doubleonick/behavior_based_bots/docs/hardware.md

# Hardware notes

What the firmware relies on, and what was learned the hard way. Facts marked
*(tested)* were confirmed on the real robot; the rest come from M5Stack's
documentation.

## Atom Matrix (ESP32-PICO)

| what | pin |
|---|---|
| 5x5 WS2812 LEDs (GRB, index = row * 5 + col, row 0 at the top) | G27 |
| Button (press the screen; LOW when pressed) | G39 |
| Internal I2C to the Motion base and the IMU: SDA / SCL | G25 / G21 |
| Grove Port A (on the Atom itself) | G26, G32 |

- Keep `FastLED.setBrightness` low (the sketches use 20): the matrix is very bright
  and gets warm.
- An old FastLED (the GitHub "FastLED-master" download) fails to compile for current
  ESP32 cores with `RMTMEM` / `gpio_matrix_out` errors. Remove it and install FastLED
  from the Library Manager. *(tested)*

## Atom Motion v1.2

The Motion's own STM32 microcontroller drives the servo and motor ports. The ESP32
only talks to it over the internal I2C bus (address **0x38**). The ESP32 has no
direct connection to the servo signal pins.

| register | meaning |
|---|---|
| 0x00–0x03 | servo S1–S4 **angle**, 1 byte, 0–180. This is what `MotionServo` uses. *(tested)* |
| 0x10, 0x12, 0x14, 0x16 | servo S1–S4 pulse width, 2 bytes, 500–2500 µs. Did not move our servo. *(tested)* |
| 0x20–0x21 | DC motor ports |

- Continuous-rotation servos: 90 = stop. `MotionServo` maps speed −1..1 to an angle,
  with a "mount" setting so "forward" is right for a wheel on either side
  (LEFT: forward is toward 180; RIGHT: forward is toward 0).
- **The servo headers can't be used as inputs.** Their signal pins belong to the STM32,
  and the register map has nothing to read back.
- Grove Port B: G23, G33, **but a unit's first wire lands on G33** (the other way round
  from Ports A and C; see the Key Unit). Grove Port C: G19, G22. *(tested)*
- Two-wheel body: with the servos at the rear of the chassis, Val_Field arced right
  when driving straight with no sensors; moving them to the middle of the chassis
  fixed it, with no change to the code. *(tested)*
- **Charging the battery** (from M5Stack's v1.2 docs): put the Motion's power switch to
  **ON**, then plug USB-C into the Atom (or feed 5 V through a Grove port). The battery
  is a removable 18350 Li-ion, 900 mAh, with DW01-A protection; charging stops at
  4.14 V. The docs don't mention a charge light. v1.2 also has an INA226 power monitor
  (battery voltage and current over I2C), not used yet.
- **On battery, units on the Motion's ports behaved differently from on USB** (Key
  Unit: no response on Ports B and C; on Port A, held HIGH / held LOW instead of
  floating / HIGH). *(seen with Unit_Tester; not yet repeated with a charged battery)*
  Possible causes: a low battery, or the ports getting less (or no) power on battery.
- Power quirk: after the Motion has been off for a long time, its power switch
  sometimes has to be toggled twice before it starts. There is no software fix.
  *(tested)*

## Val_Brooks extras (not yet tried on the robot)

- **Bump switches:** two switches to ground, read with the pin's pull-up (pressed =
  LOW). Default pins G19 (left) and G22 (right), i.e. Port C; change
  `LEFT_BUMPER_PIN` / `RIGHT_BUMPER_PIN` to match the wiring. Keep them off the PaHub's
  port.
- **IMU:** the Atom Matrix v1.1 has a BMI270 on the internal bus (G25 / G21, with the
  Motion). Val_Brooks reads it with the "SparkFun BMI270 Arduino Library", only when
  `INERTIAL_COLLISION` is 1. Which axis is the robot's front depends on how the Atom is
  mounted: set `IMU_FORWARD_AXIS` / `IMU_LEFT_AXIS` and their signs from the Serial
  readings. The v1.0 Atom Matrix has an MPU6886 instead, which this code does not read.
  `firmware/IMU_Test/` reads either chip (the MPU6886 directly, from its data sheet:
  address 0x68, WHO_AM_I 0x75 = 0x19, accelerometer from 0x3B; **not tried on a real
  one**) and shows tilt as a bubble level, for finding out what the IMU can tell about
  Val tipping over an edge, being picked up or falling. Nothing measured yet.

## Units that can't say what they are (not yet tried on the robot)

`firmware/Unit_Tester/` is for finding out what these units really do, pin by pin,
before the Val sketches rely on them: it shows each port pin's reading and whether
anything drives it (read with the weak pull-up, then the weak pull-down: an empty pin
follows them), and can drive a Key's LED once the Key has been pressed.

- **M5 Reflective IR Unit** (`ReflectiveIRSensor`): read as a **level on G32 in Port A**
  (Val_Vehicle, Val_Field: `PORT_A_UNIT IR_UNIT`), or **on/off on G33 in Port B**
  (Val_Brooks; raw 4095 = sees something, LOW on the pin = sees, *assumed, about 80%*).
  Earlier it was read as analog on G33, which was wrong (see below).
  **On the robot (Port B), G33 read binary and inverted** (a strong reflection read as
  "nothing"): so G33 gets the unit's *digital* output, which goes LOW when it sees
  something, and the analog wire lands on G23, which has no ADC. *(tested, reading;
  the digital-vs-analog explanation is the likely cause, not yet confirmed)* Analog
  IR therefore needs Port A (G26 / G32 both have an ADC).
  **Unit_Tester, on the robot:** the unit's two wires land the same way round in every
  port: its digital output on the port's *first* pin, its analog output on the
  *second*. *(tested)*
  - Port A: G26 = digital (on/off), **G32 = analog with a real range: this is where
    analog IR works.** *(tested)*
  - Port B: G23 = digital, clearly on/off. *(tested)* G33 (analog) reads only low or
    high, set by the unit's pot, with a real range only at one tiny spot of the pot.
    *(tested)* Likely cause (not yet confirmed): pull-up resistors on Port B's lines
    (for I2C) dragging the weak analog signal toward 3.3 V. Check: with nothing
    plugged in, does Unit_Tester show Port B's pins as driven?
  - **IR_Test, on the robot:** Port A gives a usable analog reading (G32) on USB and on
    battery; Port B gives on/off only (its analog output lands on G23, no ADC). Where
    to set the pot depends on the use. *(tested)*
  - The pot seems to change how strongly the IR LED shines (it moves the analog
    output too), not only the digital threshold. *(inferred from the above)* 0..4095; calibration decides which way is
  "more". The unit's digital (threshold) output is not used.
- **M5 Light Unit** (U021, labelled "Port B I/O", black; `LightUnitSensor`): read as a
  level on G32, Port A only (Val_Vehicle, Val_Field: `PORT_A_UNIT LIGHT_UNIT`). **Light_Test, on the robot:** wired like the Reflective IR. Port A:
  G26 = on/off, G32 = light level (smooth). Port B: on/off only. *(tested)* More light
  gave a bigger or smaller reading: not recorded (the owner flipped the bars so more
  light shows more).
  So it fits Port A as a level (where the ToF / Color usually go) or Port B as on/off
  (where the IR goes). A cable with its two signal wires swapped would put the level
  on G33, which can read a voltage: untried.
- **M5 Key Unit** (`KeySensor`): a button and one SK6812 LED. Both pins start as
  inputs with pull-ups; the first pin to go LOW is the button and the other becomes
  the LED (added to FastLED then).
  **Port A, with a plain test sketch** (button read with `INPUT_PULLUP`, LED driven with
  FastLED): LED on G26 (the first pin), button on G32 (the second); the button reads
  **LOW when pressed**, HIGH when not; the LED follows the colour sent. *(tested)*
  So `KeySensor`'s pull-up / LOW-when-pressed reading is right after all. Unit_Tester's
  earlier "floating, HIGH when pressed" reading was wrong; its pull-up/pull-down test
  doesn't suit this unit. *(corrected)*
  **All three ports, same sketch, pins set for each port:** *(tested)*

  | port | LED (unit's first wire) | button (second wire) |
  |---|---|---|
  | A | G26 | G32 |
  | B | **G33** | **G23** |
  | C | G19 | G22 |

  **Port B is wired the other way round** from A and C: a unit's first wire lands on
  G33, its second on G23. `KeySensor` already copes (the pin that goes LOW first is
  the button, whichever it is).
  **On battery all three ports work** (blue, red while pressed). **On USB the LED
  shows blue but does not turn red when pressed.** *(tested)* Not yet explained.
  This also explains the Reflective IR on Port B: its digital output (first wire)
  lands on G33, which is why G33 read on/off and inverted, and its analog output lands
  on G23, which has no ADC. So analog IR can only work on Port A. *(inferred from the
  Key result, high confidence)*
  The LED shows the wire / policy colour, dim, and
  bright while pressed; it shares the matrix's `FastLED.setBrightness`.
- Neither can be detected, so a sketch assumes them in Port B / C when no I2C sensor
  answers there. While only assumed (and for a key, until it is first pressed), Val
  keeps looking for an I2C sensor in that port every 5 s and uses one if it appears.

## Grove ports and what they can do

All three ports supply **5 V** on the red wire. ESP32 pins are **3.3 V only**.

| port | pins | read a voltage (ADC)? | notes |
|---|---|---|---|
| A (Atom) | G26, G32 | both | G26 is ADC2: it stops working while Wi-Fi is on. G32 (ADC1) always works. |
| B (Motion) | G23, G33 | G33 only | |
| C (Motion) | G19, G22 | neither | on/off signals only |

The sketches use a second I2C bus (`Wire1`) for the plug-in sensors and point it at a
port's pins just before each read (`I2CBus::use`). That lets one sketch serve three
ports, and lets two sensors with the same address work at once, one per port. It also
tries both wire orders, so SDA/SCL orientation never matters.

### What each unit can do in each port

**T** = tested on the robot. **E** = expected from the wiring or the firmware, not
yet tried. "Level" = a smooth reading (0..4095, or millimetres); "on/off" = only two
values.

| unit | Port A (G26 / G32) | Port B (G33 / G23) | Port C (G19 / G22) | PaHub channel | Val recognises it? | in Val's sketches |
|---|---|---|---|---|---|---|
| Color Unit (TCS3472) | level, E | level, E | level, E | level, E | yes (chip ID) | yes, any port |
| 90° ToF (VL53L0X) | level (mm), E | level (mm), E | level (mm), E | level (mm), **T** (Field, channels 0 and 1) | yes (chip ID) | yes, any port |
| Reflective IR | **level on G32, T**; on/off on G26, T | **on/off only on G33, T** | on/off only, E | no (not I2C) | no | Port A, a level (Brooks: Port B, on/off) |
| Light Unit (U021) | **level on G32, T**; on/off on G26, T | **on/off only on G33, T** | on/off only, E | no (not I2C) | no | Port A, a level |
| Key | **button G32, LED G26, T** | **button G23, LED G33, T** | **button G22, LED G19, T** | no (not I2C) | no | Port C (Brooks: A and C) |

Notes:
- **Port B is wired the other way round:** a unit's first wire lands on G33, its second
  on G23. G23 can't read a voltage, so the IR's and Light Unit's level is lost there.
  *(tested with the Key)*
- Key: works on all three ports on battery; on USB the LED showed but presses were
  not seen. *(tested, not explained)*
- IR and Light Unit on Port A: tested on USB and on battery (IR); Light Unit power
  source not recorded.
- The I2C units are found in any port by the firmware (both wire orders are tried);
  which ports each has actually been plugged into on the robot is not recorded.

### Which units fit together (one Atom + Motion)

Three ports, so three units at most, and only **one** level from an analog unit
(Port A). A PaHub in a port takes up to 6 I2C units (ToF, Color), but not analog
units or the Key: those still need a port of their own.

## Sensors the firmware recognises

Both answer at I2C address **0x29**, so the firmware asks each chip for its ID:

| sensor | chip | ID check | raw reading |
|---|---|---|---|
| M5 Color Unit | TCS3472 | register 0x92 (0x80 \| 0x12) reads 0x44, 0x4D or 0x10 | clear channel, 0–65535 (gain 4x, ~154 ms) |
| M5 ToF Unit | VL53L0X | registers 0xC0 / 0xC1 read 0xEE / 0xAA | distance in mm, capped at 2000 |

DFRobot's SEN0245 is the same VL53L0X chip, so it is recognised too.

**Pointing the Color Unit for light vehicles:** for V1 under a light shining down on
the floor (a flashlight on a stand), the Color Unit worked best **pointing up**, at
the light, not forward. *(tested, owner's filming, 2026-11)* Facing forward it sees
mostly the floor and the far wall, so the reading changes little as Val drives
through the pool of light.

Every sensor turns its raw reading into a 0..1 stimulus, a straight line between
two calibration points taken during setup: "low" (no stimulus) and "high" (full
stimulus). For distance, "high" is the *smaller* number (near).

## Considered and not used

- **DFRobot Gravity 3-pin sensors** (DFR0029 button, SEN0138 crash, DFR0034 sound).
  They need a voltage divider on Grove's 5 V, can't be told apart by the robot, and
  sound needs an ADC pin. Too fiddly for the audience. A tester sketch was written
  and then removed.
## M5 Unit PaHub (Val_Field only, for now)

A PCA9548A at address **0x70** with six channels. It connects one channel at a time
to its input (write one byte: bit n = channel n; 0 = all off), so sensors on
different channels can share an address: two distance sensors, or two light
sensors, on one port.

- Val_Field looks for a hub on each port (both wire orders) before looking for
  sensors. A port with a hub holds only the hub; its six channels are searched
  instead and named "Hub 0" to "Hub 5" by channel number.
- Every read switches the hub to that sensor's channel first (`I2CBus::use`).
- The setup screens have room for 3 sensors, so only the first 3 found are used.
- Channel numbering 0-5 matches the code and the robot: Hub 0 and Hub 1 are the
  channels the unit calls 0 and 1. *(tested)*
- Two ToF Units on one hub (right on channel 0, left on channel 1): found, set up,
  push/pull and the mounting angles all behave as expected in Val_Field, spikes
  included. *(tested)* Two light sensors on a hub: not tried on the robot yet.
