doubleonick/behavior_based_bots/cad/mg996_clamp.png

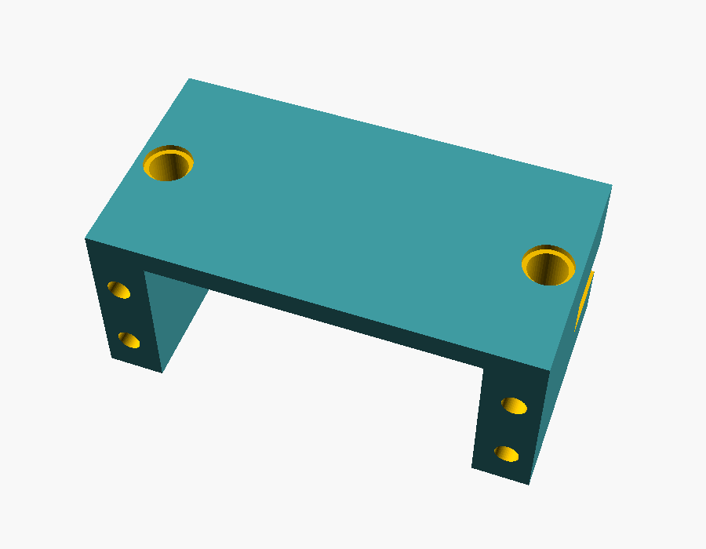
cad/mg996_clamp.png
