doubleonick/behavior_based_bots/cad/mg996_frame.png

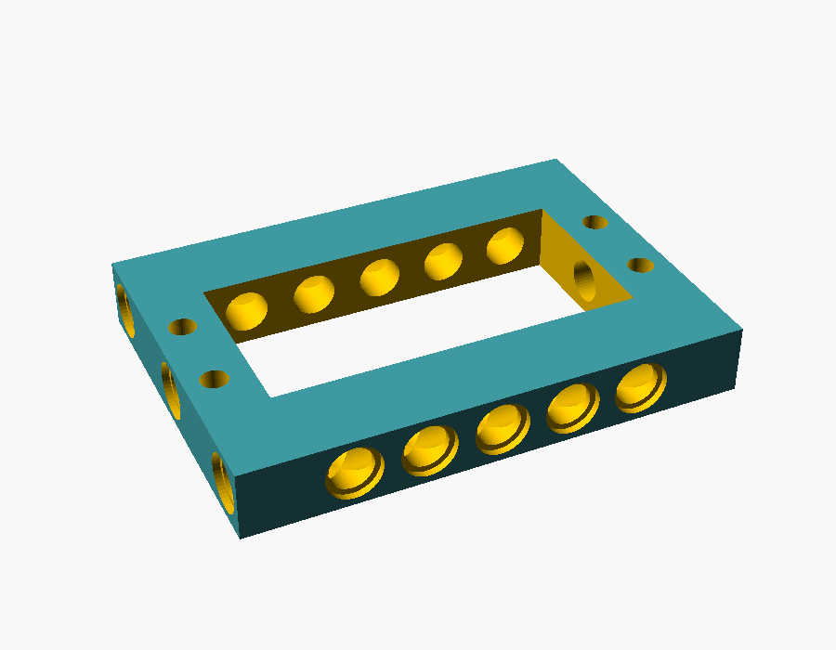
cad/mg996_frame.png
