doubleonick/behavior_based_bots/cad/mg996_horn_adapter.png

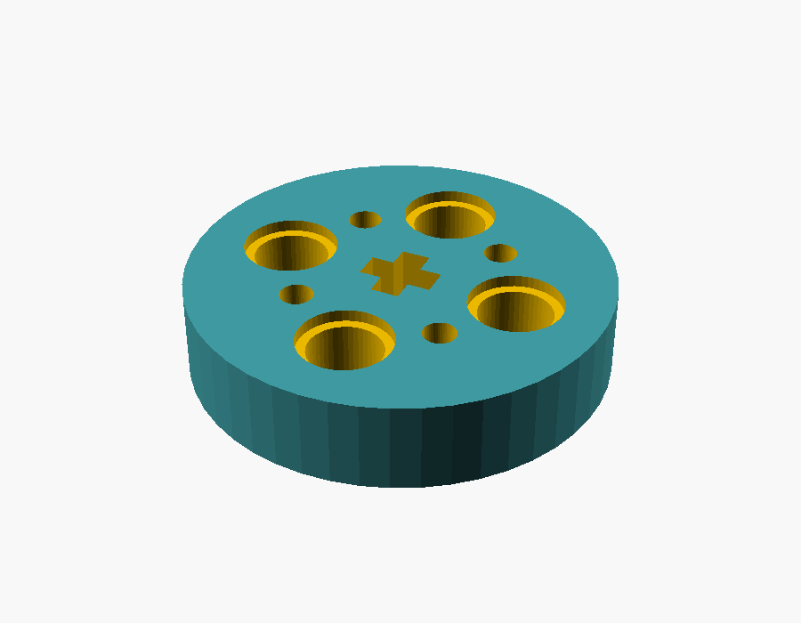
cad/mg996_horn_adapter.png
