doubleonick/behavior_based_bots/cad/mg996_preview.png

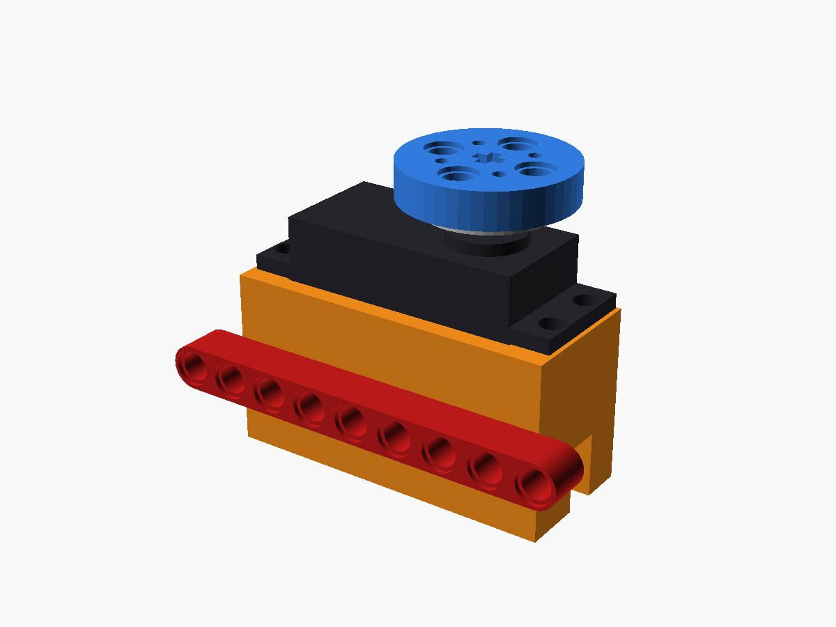
cad/mg996_preview.png
