doubleonick/behavior_based_bots/cad/mg996_preview_back.png

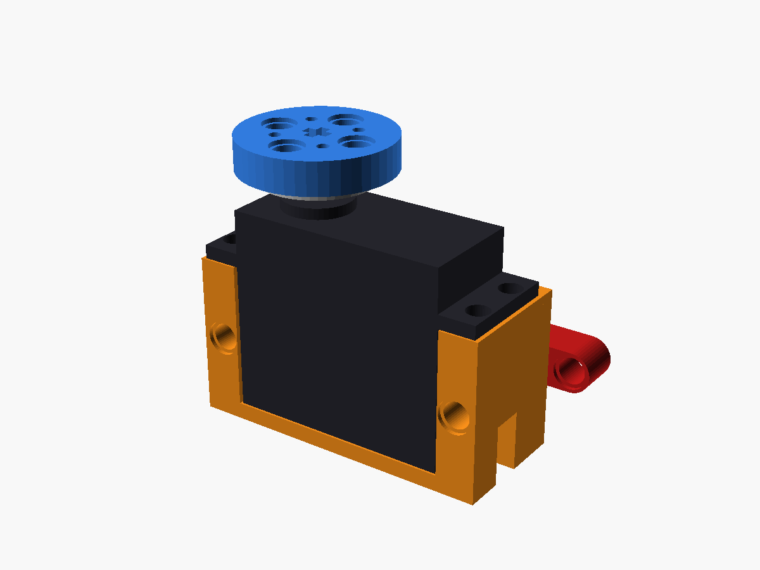
cad/mg996_preview_back.png
