doubleonick/behavior_based_bots/cad/render/val_v1_above_rear.png

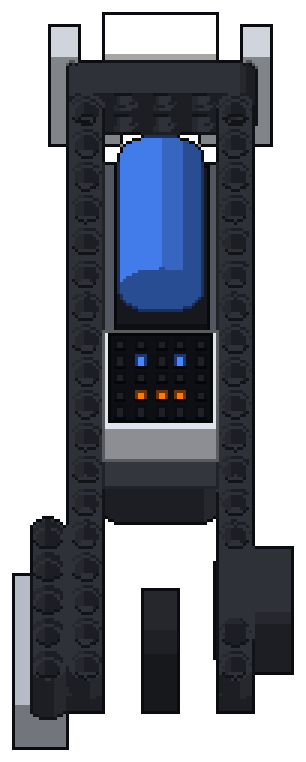
cad/render/val_v1_above_rear.png
