doubleonick/behavior_based_bots/cad/render/val_v1_rear34.png

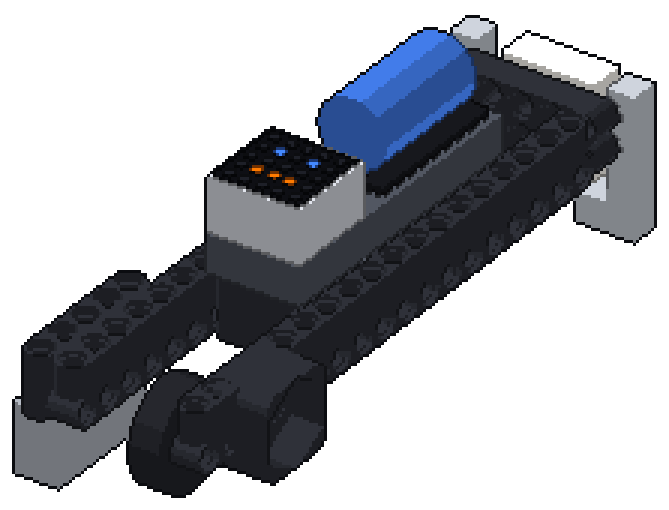
cad/render/val_v1_rear34.png
