doubleonick/behavior_based_bots/cad/render/val_v1_top.png

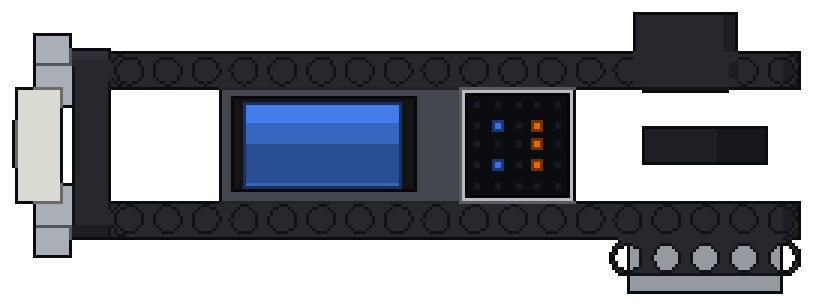
cad/render/val_v1_top.png
