doubleonick/behavior_based_bots/cad/servo_wheel_horn.png

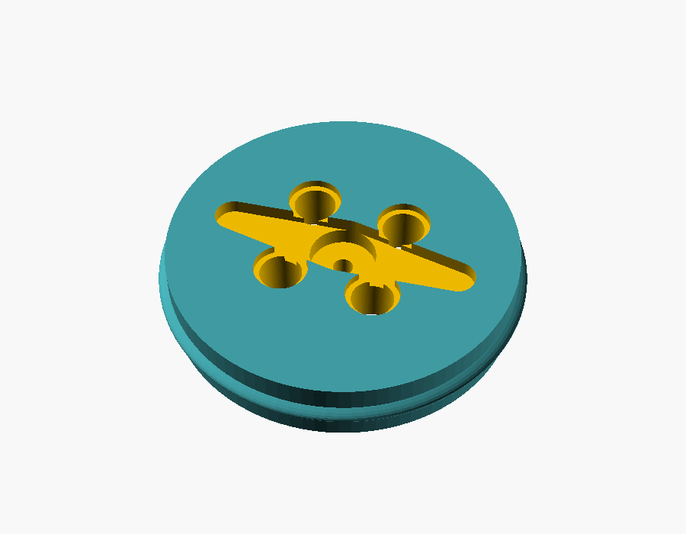
cad/servo_wheel_horn.png
