doubleonick/behavior_based_bots/cad/servo_wheel_m5.png

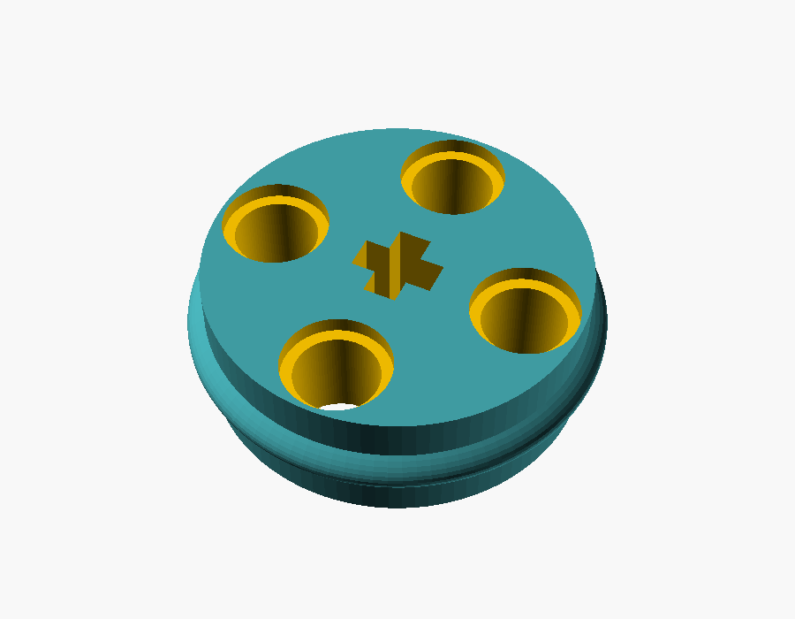
cad/servo_wheel_m5.png
