doubleonick/behavior_based_bots/cad/render/val_v1_chassis.scad

use <../vechicles_v2.scad>
val_brooks(0);
