doubleonick/behavior_based_bots/firmware/Val_Brooks/Val_Brooks.ino

/*
  Val_Brooks - behaviours in a fixed hierarchy (subsumption, after Rodney Brooks).

  Several simple behaviours run all the time. Each one keeps asking "do I want the
  wheels right now?". The highest one in the hierarchy that says yes drives the
  wheels; the ones below it are held back (suppressed) until it lets go.

  Hardware: M5 Atom Matrix on an Atom Motion base
            two continuous-rotation servos: S1 = LEFT wheel, S2 = RIGHT wheel
            an M5 PaHub in Port B (any port the keys don't use), with sensors on its channels:
              even channels (0, 2, 4) = the RIGHT side, odd channels (1, 3, 5) = the LEFT side
              M5 ToF Unit (VL53L0X)    distance
              M5 Color Unit (TCS3472)  light
              (for example: right ToF on 0, left ToF on 1, right light on 2, left light on 3)
              With only ONE Color Unit (on either side), the light behaviours compare
              its reading now with 0.2 s ago: getting brighter counts as "brighter on
              its side", getting darker as "brighter on the other side".
            for button collisions: two M5 Key Units, the LEFT one in Port A and the
              RIGHT one in Port C (or one key, or bump switches: see BUMPERS below)
            optionally an M5 Reflective IR Unit in Port B (analog on G33): "something
              just ahead" for the object behaviours
            for inertial collisions: the Atom Matrix's own IMU (BMI270, see INERTIAL_COLLISION)

  Pick the hierarchy to test in the TEST HIERARCHY section below, by leaving exactly
  one line uncommented, and the behaviour at its bottom (BOTTOM: wander or cruise). This sketch is a test bench: it has no setup screens, and its
  settings (thresholds, speeds, pins) are near the top of this file.

  The matrix:
  - Val says "Hello, my name is, Val", then the behaviours start.
  - While running, one row per behaviour (top = top of the hierarchy):
      column 0: red = push / avoid, green = pull / approach (wander: green going
      forwards, red going backwards); column 1: a gap; columns 2-4: the behaviour's
      colour: collision white, distance purple, light yellow, wander / cruise blue.
    Rows not in control stay steady. The row in control sends spikes left to right,
    as often as the wheels' average speed says.
  - Short press on the matrix: pause (wheels stop, Neutral face) / carry on.
  - Long press on the matrix: the behaviour display off (the matrix goes dark) / on.
    With it off, the robot gives nothing away: for watching what it does and
    working out its hierarchy from behaviour alone. SHOW_LAYERS_AT_START sets how
    it begins.

  Keep all these files together in a folder named Val_Brooks. The shared ones
  (Face, Static, Canvas, Palette, Icons, MotionServo, Port, I2CBus, Sensor, ColorSensor,
  DistanceSensor, ReflectiveIRSensor, KeySensor, Button)
  are copies of firmware/shared/ - edit them there and run sync_shared.py.

  Libraries needed: FastLED, VL53L0X by Pololu, and only for INERTIAL_COLLISION 1:
  "SparkFun BMI270 Arduino Library".
  Readings print on Serial at 115200 baud.
*/

#include <Wire.h>
#include <FastLED.h>
#include "Face.h"
#include "Button.h"
#include "MotionServo.h"
#include "ColorSensor.h"
#include "DistanceSensor.h"
#include "ReflectiveIRSensor.h"
#include "KeySensor.h"
#include "I2CBus.h"
#include "Layers.h"

// =====================================================================
//  TEST HIERARCHY: uncomment exactly ONE line (top of the hierarchy first)
// =====================================================================
// #define TEST_ESCAPE_LEFT      // 1. escape left collision  -> bottom
// #define TEST_ESCAPE_RIGHT     // 2. escape right collision -> bottom
// #define TEST_AVOID_OBJECT     // 3. avoid object           -> bottom
// #define TEST_APPROACH_OBJECT  // 4. approach object        -> bottom
// #define TEST_AVOID_LIGHT      // 5. avoid light            -> bottom
// #define TEST_APPROACH_LIGHT   // 6. approach light         -> bottom
#define TEST_FULL                // escape front collision -> avoid object -> approach light -> bottom

// The bottom of the hierarchy has no condition: it always wants the wheels, so nothing
// can go below it. Uncomment exactly ONE:
#ifndef BOTTOM
#define BOTTOM WANDER            // roll a die every 0.2 s for one of six moves
// #define BOTTOM CRUISE_STRAIGHT   // a "forced roll": always straight ahead at half speed
#endif

// ---------- Collision detection: which kind? ----------
// 0 = bump switches (is_button_collision), 1 = the IMU (is_inertial_collision)
#define INERTIAL_COLLISION 0

// ---------- Settings ----------
const uint8_t LED_BRIGHTNESS = 20;    // keep low: the matrix is very bright and gets warm
const bool SHOW_LAYERS_AT_START = true;   // false: start with the behaviour display off (dark)

// Bumpers: 1 = one M5 Key Unit in Port C, a front bumper (it counts as left AND right)
//           2 = two bump switches on Port C: left on G19, right on G22, pressed = LOW
//              (they use the pin's pull-up)
//           3 = two M5 Key Units: the LEFT one in Port A, the RIGHT one in Port C
//              (to swap sides, swap leftKey and rightKey below)
// Key LEDs show red ("push away"), like the setup screens.
#ifndef BUMPERS
#define BUMPERS 3
#endif
const int LEFT_BUMPER_PIN  = 19;
const int RIGHT_BUMPER_PIN = 22;

// Reflective IR in Port B: 1 = use one if no PaHub is there, 0 = don't
#ifndef ASSUME_IR_ON_PORT_B
#define ASSUME_IR_ON_PORT_B 1
#endif
// A raw reading (0..4095) past this means "something just ahead". Which way "past" is
// depends on the unit: watch the "ir" number on Serial with and without something there.
const long IR_NEAR_RAW = 2000;
const bool IR_NEAR_IS_HIGH = true;    // true: something near gives a BIGGER reading

// Distance: an object nearer than this (mm) on either side is "there"
const long DISTANCE_THRESHOLD_MM = 300;
// Light: (left - right) / (left + right) must be at least this, either way, to count
const float LIGHT_GRADIENT_THRESHOLD = 0.25f;
const long  LIGHT_MINIMUM = 50;       // left + right below this: too dark to tell
// One light sensor only (no pair): it compares now with PRIMITIVE_MS ago instead.
// A change of at least this fraction (0.15 = 15% brighter or darker) counts.
const float LIGHT_CHANGE_THRESHOLD = 0.15f;

// IMU (only with INERTIAL_COLLISION 1). A bump is a sudden change in acceleration.
const float IMPACT_G = 0.6f;          // how big a sudden change counts as a bump (in g)
// Which IMU axis points to the robot's front and which to its left, and their signs.
// Depends on how the Atom sits on the robot: check with the Serial readings.
const int   IMU_FORWARD_AXIS = 0;     // 0 = x, 1 = y, 2 = z
const float IMU_FORWARD_SIGN = 1.0f;
const int   IMU_LEFT_AXIS    = 1;
const float IMU_LEFT_SIGN    = 1.0f;

// Speeds (-1..1, positive = forwards)
const float STRAIGHT_SPEED = 0.5f;
const float ARC_FAST = 0.55f;         // the outside wheel of an arc
const float ARC_SLOW = 0.25f;         // the inside wheel of an arc
const float ROTATE_SPEED = 0.4f;      // turning on the spot: one wheel forwards, one backwards
const float CRUISE_SPEED = 0.5f;      // cruise straight

// Timing
const unsigned long PRIMITIVE_MS = 200;     // wander rolls the die this often; approach and
                                            // avoid turn for this long, then look again
const unsigned long ESCAPE_MS = 1000;       // escape: back away (one side hit) or turn on the
                                            // spot (both sides hit) for this long
const unsigned long BOTH_WINDOW_MS = 100;   // the other key pressed within this long counts as both

#if INERTIAL_COLLISION
#include "SparkFun_BMI270_Arduino_Library.h"
BMI270 imu;
#endif

// ---------- Hardware ----------
CRGB leds[25];
Face face(leds);
Layers layers(leds);
Button button(39);                    // the Matrix screen is the button
MotionServo leftWheel(1);             // S1
MotionServo rightWheel(2);            // S2

// ---------- Sensors on the PaHub ----------
const int PORT_COUNT = 3;
const Port PORTS[PORT_COUNT] = {PORT_A, PORT_B, PORT_C};
const int CHANNELS = I2CBus::HUB_CHANNELS;
Port hubPlace[CHANNELS] = {
  {"Hub 0", -1, -1, 0}, {"Hub 1", -1, -1, 1}, {"Hub 2", -1, -1, 2},
  {"Hub 3", -1, -1, 3}, {"Hub 4", -1, -1, 4}, {"Hub 5", -1, -1, 5}
};
ColorSensor colorSensor[CHANNELS] = {
  ColorSensor(hubPlace[0]), ColorSensor(hubPlace[1]), ColorSensor(hubPlace[2]),
  ColorSensor(hubPlace[3]), ColorSensor(hubPlace[4]), ColorSensor(hubPlace[5])
};
DistanceSensor distanceSensor[CHANNELS] = {
  DistanceSensor(hubPlace[0]), DistanceSensor(hubPlace[1]), DistanceSensor(hubPlace[2]),
  DistanceSensor(hubPlace[3]), DistanceSensor(hubPlace[4]), DistanceSensor(hubPlace[5])
};
int hubPort = -1;                     // which port the PaHub is in (-1 = none found)

ReflectiveIRSensor reflectiveIR(PORT_B);
KeySensor keyA(PORT_A);
KeySensor keyC(PORT_C);
KeySensor* leftKey = &keyA;           // BUMPERS 3: which key is on which side
KeySensor* rightKey = &keyC;

// The sensors each behaviour uses (nullptr = not plugged in)
Sensor* leftDistance  = nullptr;
Sensor* rightDistance = nullptr;
Sensor* leftLight     = nullptr;
Sensor* rightLight    = nullptr;

// ---------- The behaviours ----------
enum Behaviour : uint8_t {
  ESCAPE_LEFT_COLLISION, ESCAPE_RIGHT_COLLISION, ESCAPE_FRONT_COLLISION,
  AVOID_OBJECT, APPROACH_OBJECT, AVOID_LIGHT, APPROACH_LIGHT, WANDER, CRUISE_STRAIGHT,
  BEHAVIOUR_COUNT                     // (not a behaviour: how many there are)
};

#if defined(TEST_ESCAPE_LEFT)
const Behaviour HIERARCHY[] = {ESCAPE_LEFT_COLLISION, BOTTOM};
#elif defined(TEST_ESCAPE_RIGHT)
const Behaviour HIERARCHY[] = {ESCAPE_RIGHT_COLLISION, BOTTOM};
#elif defined(TEST_AVOID_OBJECT)
const Behaviour HIERARCHY[] = {AVOID_OBJECT, BOTTOM};
#elif defined(TEST_APPROACH_OBJECT)
const Behaviour HIERARCHY[] = {APPROACH_OBJECT, BOTTOM};
#elif defined(TEST_AVOID_LIGHT)
const Behaviour HIERARCHY[] = {AVOID_LIGHT, BOTTOM};
#elif defined(TEST_APPROACH_LIGHT)
const Behaviour HIERARCHY[] = {APPROACH_LIGHT, BOTTOM};
#elif defined(TEST_FULL)
const Behaviour HIERARCHY[] = {ESCAPE_FRONT_COLLISION, AVOID_OBJECT, APPROACH_LIGHT, BOTTOM};
#else
#error "Uncomment one TEST_ line in the TEST HIERARCHY section"
#endif
const int LEVELS = sizeof(HIERARCHY) / sizeof(HIERARCHY[0]);

// ---------- State ----------
float wheelLeft = 0;                  // what the behaviour in control asked for
float wheelRight = 0;
int inControl = -1;                   // index into HIERARCHY
bool paused = false;
bool showLayers = SHOW_LAYERS_AT_START;   // long press turns the behaviour display on / off
bool matrixDark = false;              // the display is off and the matrix has been cleared
bool greetingDone = false;
unsigned long lastPrintMs = 0;

// An escape is a fixed move: once it starts, it runs to the end
enum EscapeMove : uint8_t { BACK_LEFT, BACK_RIGHT, SPIN_LEFT, SPIN_RIGHT };
struct Escape {
  bool running = false;
  unsigned long startMs = 0;
  EscapeMove move = BACK_LEFT;
};
Escape escape;

// Approach and avoid: a turn on the spot lasts PRIMITIVE_MS, then the behaviour looks again
struct Turn {
  bool running = false;
  unsigned long startMs = 0;
  bool right = true;
};
Turn turns[BEHAVIOUR_COUNT];

// One light sensor: its reading now and PRIMITIVE_MS ago
long lightNow = 0;
long lightBefore = 0;
unsigned long lastLightSampleMs = 0;
bool lightSampled = false;            // false until there are two samples to compare

// Wander: the current roll of the die and when it was rolled
int wanderRoll = 0;                   // 0..5
unsigned long lastRollMs = 0;
bool wanderStarted = false;

// =====================================================================
//  Finding the hub and the sensors on it
// =====================================================================
void findHub() {
  for (int p = 0; p < PORT_COUNT; p++) {
    const int orders[2][2] = {{PORTS[p].pin1, PORTS[p].pin2}, {PORTS[p].pin2, PORTS[p].pin1}};
    for (int n = 0; n < 2; n++) {
      I2CBus::use(orders[n][0], orders[n][1]);
      if (!I2CBus::hubAnswers()) {
        continue;
      }
      I2CBus::hubAllOff();
      hubPort = p;
      for (int ch = 0; ch < CHANNELS; ch++) {
        hubPlace[ch].pin1 = PORTS[p].pin1;
        hubPlace[ch].pin2 = PORTS[p].pin2;
        colorSensor[ch].setPort(hubPlace[ch]);
        distanceSensor[ch].setPort(hubPlace[ch]);
      }
      Serial.printf("PaHub found on %s\n", PORTS[p].name);
      return;
    }
  }
  Serial.println("No PaHub found: distance and light behaviours will never act");
}

// Even channels are the right side, odd channels the left
void findSensors() {
  if (hubPort < 0) {
    return;
  }
  for (int ch = 0; ch < CHANNELS; ch++) {
    bool left = (ch % 2 == 1);
    if (distanceSensor[ch].begin()) {
      if (left && leftDistance == nullptr) {
        leftDistance = &distanceSensor[ch];
      } else if (!left && rightDistance == nullptr) {
        rightDistance = &distanceSensor[ch];
      }
    } else if (colorSensor[ch].begin()) {
      if (left && leftLight == nullptr) {
        leftLight = &colorSensor[ch];
      } else if (!left && rightLight == nullptr) {
        rightLight = &colorSensor[ch];
      }
    }
  }
}

bool present(Sensor* s) {
  return s != nullptr && s->isConnected();
}

void updateSensors() {
  Sensor* all[7] = {leftDistance, rightDistance, leftLight, rightLight, &reflectiveIR, &keyA, &keyC};
  for (int k = 0; k < 7; k++) {
    if (all[k] != nullptr) {
      all[k]->update();
    }
  }
}

// =====================================================================
//  Detection: what is out there?
// =====================================================================
bool is_left_bumper_pressed() {
#if BUMPERS == 1
  return keyC.pressed();              // one key at the front: it is both sides
#elif BUMPERS == 2
  return digitalRead(LEFT_BUMPER_PIN) == LOW;
#else
  return leftKey->pressed();
#endif
}

bool is_right_bumper_pressed() {
#if BUMPERS == 1
  return keyC.pressed();
#elif BUMPERS == 2
  return digitalRead(RIGHT_BUMPER_PIN) == LOW;
#else
  return rightKey->pressed();
#endif
}

// A bump switch was pressed (either side)
bool is_button_collision() {
  return is_left_bumper_pressed() || is_right_bumper_pressed();
}

// ---- The IMU: a bump is a sudden change in acceleration ----
float impactForward = 0;              // how big the latest sudden change is, toward the front
float impactLeft = 0;                 // ... and toward the left

#if INERTIAL_COLLISION
float slowAccel[3] = {0, 0, 0};       // acceleration, followed slowly (gravity and steady driving)
bool imuReady = false;
unsigned long lastImuMs = 0;

void beginImu() {
  imuReady = (imu.beginI2C(BMI2_I2C_PRIM_ADDR, Wire) == BMI2_OK);
  Serial.printf("IMU (BMI270) %s\n", imuReady ? "found" : "NOT found");
}

// Read the IMU every 10 ms; a sudden change = this reading minus the slow average
void updateImu() {
  if (!imuReady || millis() - lastImuMs < 10) {
    return;
  }
  lastImuMs = millis();
  if (imu.getSensorData() != BMI2_OK) {
    return;
  }
  float a[3] = {imu.data.accelX, imu.data.accelY, imu.data.accelZ};
  float sudden[3];
  for (int k = 0; k < 3; k++) {
    sudden[k] = a[k] - slowAccel[k];
    slowAccel[k] += 0.05f * (a[k] - slowAccel[k]);
  }
  impactForward = IMU_FORWARD_SIGN * sudden[IMU_FORWARD_AXIS];
  impactLeft = IMU_LEFT_SIGN * sudden[IMU_LEFT_AXIS];
}
#else
void beginImu() {
}

void updateImu() {
}
#endif

// A sudden jolt bigger than IMPACT_G, from any side
bool is_inertial_collision() {
#if INERTIAL_COLLISION
  return sqrtf(impactForward * impactForward + impactLeft * impactLeft) >= IMPACT_G;
#else
  return false;                       // not compiled in: set INERTIAL_COLLISION to 1
#endif
}

// Something hit the left side: the left bumper, or a jolt that pushes the robot right
bool is_left_collision() {
#if INERTIAL_COLLISION
  return is_inertial_collision() && impactLeft < 0;
#else
  return is_left_bumper_pressed();
#endif
}

bool is_right_collision() {
#if INERTIAL_COLLISION
  return is_inertial_collision() && impactLeft > 0;
#else
  return is_right_bumper_pressed();
#endif
}

// Something hit the front: left and right together (bump switches), or any jolt (IMU)
bool is_front_collision() {
#if INERTIAL_COLLISION
  return is_inertial_collision();
#else
  return is_button_collision();
#endif
}

// Does the reflective IR see something just ahead?
bool is_ir_object_ahead() {
  if (!present(&reflectiveIR)) {
    return false;
  }
  if (IR_NEAR_IS_HIGH) {
    return reflectiveIR.raw() >= IR_NEAR_RAW;
  }
  return reflectiveIR.raw() <= IR_NEAR_RAW;
}

// Is an object nearer than DISTANCE_THRESHOLD_MM on either side (or just ahead, by IR)?
bool is_distance_threshold() {
  bool leftNear = present(leftDistance) && leftDistance->raw() < DISTANCE_THRESHOLD_MM;
  bool rightNear = present(rightDistance) && rightDistance->raw() < DISTANCE_THRESHOLD_MM;
  return leftNear || rightNear || is_ir_object_ahead();
}

// ---- Light: a pair compares left with right; one sensor compares now with before ----
bool light_pair() {
  return present(leftLight) && present(rightLight);
}

// The only light sensor, if there is exactly one (nullptr otherwise)
Sensor* single_light() {
  if (light_pair()) {
    return nullptr;
  }
  if (present(leftLight)) {
    return leftLight;
  }
  if (present(rightLight)) {
    return rightLight;
  }
  return nullptr;
}

// One sensor: take a sample every PRIMITIVE_MS
void sample_light() {
  Sensor* s = single_light();
  if (s == nullptr) {
    lightSampled = false;
    return;
  }
  if (lastLightSampleMs != 0 && millis() - lastLightSampleMs < PRIMITIVE_MS) {
    return;
  }
  lightSampled = (lastLightSampleMs != 0);
  lastLightSampleMs = millis();
  lightBefore = lightNow;
  lightNow = s->raw();
}

// One sensor: how much brighter it got since the last sample (0.5 = 50% brighter, - = darker)
float light_change() {
  if (single_light() == nullptr || !lightSampled) {
    return 0;
  }
  long before = max(lightBefore, LIGHT_MINIMUM);
  return (float)(lightNow - lightBefore) / before;
}

// How much brighter the left is than the right: -1 (all right) .. +1 (all left).
// One sensor: getting brighter counts as "brighter on its side", darker as the other.
float light_gradient() {
  Sensor* one = single_light();
  if (one != nullptr) {
    float change = light_change();
    if (one == rightLight) {
      change = -change;                // a sensor on the right: brighter means the right
    }
    return change;
  }
  if (!light_pair()) {
    return 0;
  }
  long total = leftLight->raw() + rightLight->raw();
  if (total < LIGHT_MINIMUM) {
    return 0;                          // too dark to tell
  }
  return (float)(leftLight->raw() - rightLight->raw()) / total;
}

// Is one side clearly brighter than the other? (One sensor: did it clearly change?)
bool is_light_gradient_threshold() {
  if (single_light() != nullptr) {
    return fabsf(light_change()) >= LIGHT_CHANGE_THRESHOLD;
  }
  return fabsf(light_gradient()) >= LIGHT_GRADIENT_THRESHOLD;
}

// How near something is on each side: 0 = at the threshold or further, 1 = touching
float nearness(Sensor* s) {
  if (!present(s)) {
    return 0;
  }
  float n = 1.0f - (float)s->raw() / DISTANCE_THRESHOLD_MM;
  return constrain(n, 0.0f, 1.0f);
}

// =====================================================================
//  Primitives: set the two wheels
// =====================================================================
void set_wheels(float left, float right) {
  wheelLeft = left;
  wheelRight = right;
}

void straight_forward()   { set_wheels(STRAIGHT_SPEED, STRAIGHT_SPEED); }
void straight_backward()  { set_wheels(-STRAIGHT_SPEED, -STRAIGHT_SPEED); }
void arc_forward_left()   { set_wheels(ARC_SLOW, ARC_FAST); }      // the left wheel is on the inside
void arc_forward_right()  { set_wheels(ARC_FAST, ARC_SLOW); }
void arc_backward_left()  { set_wheels(-ARC_SLOW, -ARC_FAST); }    // the back swings left, the nose turns right
void arc_backward_right() { set_wheels(-ARC_FAST, -ARC_SLOW); }    // the back swings right, the nose turns left
void rotate_left()        { set_wheels(-ROTATE_SPEED, ROTATE_SPEED); }   // on the spot
void rotate_right()       { set_wheels(ROTATE_SPEED, -ROTATE_SPEED); }
void cruise_straight()    { set_wheels(CRUISE_SPEED, CRUISE_SPEED); }

// =====================================================================
//  Behaviours: what each one does when it has the wheels
// =====================================================================
// ---- Escapes ----
void start_escape(EscapeMove move) {
  escape.running = true;
  escape.startMs = millis();
  escape.move = move;
}

// Turn on the spot, either way (a coin flip)
EscapeMove spin_either_way() {
  if (esp_random() & 1) {
    return SPIN_LEFT;
  }
  return SPIN_RIGHT;
}

// Is an escape still under way? (It lets go of the wheels once its time is up.)
bool escape_still_running() {
  if (escape.running && millis() - escape.startMs >= ESCAPE_MS) {
    escape.running = false;
  }
  return escape.running;
}

void run_escape() {
  if (escape.move == BACK_LEFT) {
    arc_backward_left();               // the back swings left, the nose turns right
  } else if (escape.move == BACK_RIGHT) {
    arc_backward_right();              // the back swings right, the nose turns left
  } else if (escape.move == SPIN_LEFT) {
    rotate_left();
  } else {
    rotate_right();
  }
}

// Hit on the left: back up to the left, so the nose turns right, away from the hit
void escape_left_collision() {
  if (!escape.running) {
    start_escape(BACK_LEFT);
  }
  run_escape();
}

void escape_right_collision() {
  if (!escape.running) {
    start_escape(BACK_RIGHT);
  }
  run_escape();
}

// Left and right combined:
//   both sides hit (within BOTH_WINDOW_MS of each other): turn on the spot
//   left only: back up to the left.  right only: back up to the right.
void escape_front_collision() {
  bool left = is_left_collision();
  bool right = is_right_collision();
  if (!escape.running) {
    if (left && right) {
      start_escape(spin_either_way());
    } else if (left) {
      start_escape(BACK_LEFT);
    } else if (right) {
      start_escape(BACK_RIGHT);
    } else {
      start_escape(spin_either_way());   // a jolt dead ahead (IMU): no side to tell
    }
  } else if (millis() - escape.startMs < BOTH_WINDOW_MS && left && right) {
    bool backing = (escape.move == BACK_LEFT || escape.move == BACK_RIGHT);
    if (backing) {
      start_escape(spin_either_way());   // the other side was hit just after: it was both
    }
  }
  run_escape();
}

// ---- Approach and avoid: turn on the spot for PRIMITIVE_MS, then look again ----
bool turn_still_running(Behaviour b) {
  if (turns[b].running && millis() - turns[b].startMs >= PRIMITIVE_MS) {
    turns[b].running = false;
  }
  return turns[b].running;
}

// stronger: + = stronger on the left, - = on the right, 0 = the same (a coin flip).
// towards: true = turn toward the stronger side (approach), false = away (avoid).
void turn_by(Behaviour b, float stronger, bool towards) {
  if (!turns[b].running) {
    bool leftStronger;
    if (stronger > 0) {
      leftStronger = true;
    } else if (stronger < 0) {
      leftStronger = false;
    } else {
      leftStronger = (esp_random() & 1);
    }
    turns[b].running = true;
    turns[b].startMs = millis();
    if (towards) {
      turns[b].right = !leftStronger;
    } else {
      turns[b].right = leftStronger;
    }
  }
  if (turns[b].right) {
    rotate_right();
  } else {
    rotate_left();
  }
}

// Only the reflective IR sees it (dead ahead, no side): no side to turn by
bool only_ir_sees_it() {
  bool leftNear = present(leftDistance) && leftDistance->raw() < DISTANCE_THRESHOLD_MM;
  bool rightNear = present(rightDistance) && rightDistance->raw() < DISTANCE_THRESHOLD_MM;
  return is_ir_object_ahead() && !leftNear && !rightNear;
}

// Nearer on the left: turn right, away from it. Dead ahead (IR only): either way.
void avoid_object() {
  float stronger = nearness(leftDistance) - nearness(rightDistance);
  if (only_ir_sees_it()) {
    stronger = 0;
  }
  turn_by(AVOID_OBJECT, stronger, false);
}

// Nearer on the left: turn left, toward it. Dead ahead (IR only): keep going straight at it.
void approach_object() {
  if (only_ir_sees_it() && !turns[APPROACH_OBJECT].running) {
    straight_forward();
    return;
  }
  float stronger = nearness(leftDistance) - nearness(rightDistance);
  turn_by(APPROACH_OBJECT, stronger, true);
}

// Brighter on the left: avoid turns right, approach turns left
void avoid_light()    { turn_by(AVOID_LIGHT, light_gradient(), false); }
void approach_light() { turn_by(APPROACH_LIGHT, light_gradient(), true); }

// Roll a die every PRIMITIVE_MS for one of six moves (no turning on the spot)
void roll_wander() {
  wanderRoll = esp_random() % 6;
  lastRollMs = millis();
}

bool wander_goes_forward() {
  return wanderRoll == 0 || wanderRoll == 2 || wanderRoll == 3;
}

void wander() {
  switch (wanderRoll) {
    case 0: straight_forward();   break;
    case 1: straight_backward();  break;
    case 2: arc_forward_left();   break;
    case 3: arc_forward_right();  break;
    case 4: arc_backward_left();  break;
    case 5: arc_backward_right(); break;
  }
}

// =====================================================================
//  The hierarchy
// =====================================================================
const char* behaviourName(Behaviour b) {
  switch (b) {
    case ESCAPE_LEFT_COLLISION:  return "Escape left collision";
    case ESCAPE_RIGHT_COLLISION: return "Escape right collision";
    case ESCAPE_FRONT_COLLISION: return "Escape front collision";
    case AVOID_OBJECT:           return "Avoid object";
    case APPROACH_OBJECT:        return "Approach object";
    case AVOID_LIGHT:            return "Avoid light";
    case APPROACH_LIGHT:         return "Approach light";
    case WANDER:                 return "Wander";
    case CRUISE_STRAIGHT:        return "Cruise straight";
    case BEHAVIOUR_COUNT:        break;
  }
  return "?";
}

// Does this behaviour want the wheels right now?
bool wantsControl(Behaviour b) {
  switch (b) {
    case ESCAPE_LEFT_COLLISION:  return escape_still_running() || is_left_collision();
    case ESCAPE_RIGHT_COLLISION: return escape_still_running() || is_right_collision();
    case ESCAPE_FRONT_COLLISION: return escape_still_running() || is_front_collision();
    case AVOID_OBJECT:           return turn_still_running(b) || is_distance_threshold();
    case APPROACH_OBJECT:        return turn_still_running(b) || is_distance_threshold();
    case AVOID_LIGHT:            return turn_still_running(b) || is_light_gradient_threshold();
    case APPROACH_LIGHT:         return turn_still_running(b) || is_light_gradient_threshold();
    case WANDER:                 return true;       // always: the bottom of the hierarchy
    case CRUISE_STRAIGHT:        return true;       // always: the bottom of the hierarchy
    case BEHAVIOUR_COUNT:        break;
  }
  return false;
}

void act(Behaviour b) {
  switch (b) {
    case ESCAPE_LEFT_COLLISION:  escape_left_collision();  break;
    case ESCAPE_RIGHT_COLLISION: escape_right_collision(); break;
    case ESCAPE_FRONT_COLLISION: escape_front_collision(); break;
    case AVOID_OBJECT:           avoid_object();           break;
    case APPROACH_OBJECT:        approach_object();        break;
    case AVOID_LIGHT:            avoid_light();            break;
    case APPROACH_LIGHT:         approach_light();         break;
    case WANDER:                 wander();                 break;
    case CRUISE_STRAIGHT:        cruise_straight();        break;
    case BEHAVIOUR_COUNT:        break;
  }
}

// The first behaviour from the top that wants control gets it
void arbitrate() {
  // Wander keeps rolling its die underneath, whoever is in control
  if (!wanderStarted || millis() - lastRollMs >= PRIMITIVE_MS) {
    wanderStarted = true;
    roll_wander();
  }
  int winner = LEVELS - 1;
  for (int level = 0; level < LEVELS; level++) {
    if (wantsControl(HIERARCHY[level])) {
      winner = level;
      break;
    }
  }
  if (winner != inControl) {
    inControl = winner;
    layers.start();
  }
  act(HIERARCHY[inControl]);           // sets wheelLeft / wheelRight
}

// =====================================================================
//  The matrix
// =====================================================================
const Canvas::Color* signFor(Behaviour b) {
  switch (b) {
    case APPROACH_OBJECT:
    case APPROACH_LIGHT:
      return &Palette::GREEN;
    case WANDER:
      return wander_goes_forward() ? &Palette::GREEN : &Palette::RED;
    case CRUISE_STRAIGHT:
      return &Palette::GREEN;            // always forwards
    default:
      return &Palette::RED;              // escapes and avoids push away
  }
}

const Canvas::Color* colourFor(Behaviour b) {
  switch (b) {
    case ESCAPE_LEFT_COLLISION:
    case ESCAPE_RIGHT_COLLISION:
    case ESCAPE_FRONT_COLLISION:
      return &Palette::WHITE;
    case AVOID_OBJECT:
    case APPROACH_OBJECT:
      return &Palette::PURPLE;
    case AVOID_LIGHT:
    case APPROACH_LIGHT:
      return &Palette::YELLOW;
    case WANDER:
    case CRUISE_STRAIGHT:
      return &Palette::BLUE;
    case BEHAVIOUR_COUNT:
      break;
  }
  return &Palette::WHITE;
}

void drawLayers() {
  layers.setRows(LEVELS);
  for (int level = 0; level < LEVELS; level++) {
    layers.setRow(level, signFor(HIERARCHY[level]), colourFor(HIERARCHY[level]));
  }
  layers.setInControl(inControl);
  layers.setWheels(wheelLeft, wheelRight);
  layers.update();
}

// =====================================================================
//  Serial
// =====================================================================
void printLong(const char* label, Sensor* s) {
  if (present(s)) {
    Serial.printf("%s %5ld  ", label, s->raw());
  }
}

void printStatus() {
  if (millis() - lastPrintMs < 500) {
    return;
  }
  lastPrintMs = millis();
  printLong("distL", leftDistance);
  printLong("distR", rightDistance);
  printLong("lightL", leftLight);
  printLong("lightR", rightLight);
  printLong("ir", &reflectiveIR);
#if INERTIAL_COLLISION
  Serial.printf("jolt fwd %+.2f left %+.2f  ", impactForward, impactLeft);
#elif BUMPERS == 1
  Serial.printf("key %c  ", keyC.pressed() ? 'X' : '-');
#elif BUMPERS == 3
  Serial.printf("keys %c%c  ", is_left_bumper_pressed() ? 'L' : '-', is_right_bumper_pressed() ? 'R' : '-');
#else
  Serial.printf("bumpers %c%c  ", is_left_bumper_pressed() ? 'L' : '-', is_right_bumper_pressed() ? 'R' : '-');
#endif
  if (paused) {
    Serial.printf("| paused\n");
    return;
  }
  if (inControl < 0) {
    Serial.printf("| starting\n");     // the greeting: no behaviour has had control yet
    return;
  }
  Serial.printf("| %s -> L %+.2f R %+.2f\n", behaviourName(HIERARCHY[inControl]), wheelLeft, wheelRight);
}

// =====================================================================
//  Setup / loop
// =====================================================================
void setup() {
  Serial.begin(115200);
  delay(200);
  button.begin();
#if BUMPERS == 2
  pinMode(LEFT_BUMPER_PIN, INPUT_PULLUP);
  pinMode(RIGHT_BUMPER_PIN, INPUT_PULLUP);
#endif
  FastLED.addLeds<WS2812, 27, GRB>(leds, 25);
  FastLED.setBrightness(LED_BRIGHTNESS);
  FastLED.clear(true);

  leftWheel.begin();                  // finds the Motion base (both servos are on it)
  leftWheel.setMount(MotionServo::LEFT);
  rightWheel.setMount(MotionServo::RIGHT);
  leftWheel.setAllowReverse(true);
  rightWheel.setAllowReverse(true);
  rightWheel.stopNow();
  beginImu();                         // the IMU shares the Motion's bus

  findHub();
  findSensors();
  if (BUMPERS != 3 && hubPort == 2) {
    Serial.println("Warning: the PaHub is in Port C, where the bumpers go");
  } else if (BUMPERS == 1) {
    keyC.begin();
  }
  if (BUMPERS == 3) {
    if (hubPort == 0 || hubPort == 2) {
      Serial.println("Warning: the PaHub is in a key's port (A or C): put it in Port B");
    }
    if (hubPort != 0) {
      keyA.begin();
    }
    if (hubPort != 2) {
      keyC.begin();
    }
  }
  if (ASSUME_IR_ON_PORT_B && hubPort != 1) {
    reflectiveIR.begin();
  }

  Serial.printf("Hierarchy (top first):");
  for (int level = 0; level < LEVELS; level++) {
    Serial.printf(" %s%s", behaviourName(HIERARCHY[level]), level < LEVELS - 1 ? " ->" : "\n");
  }

  face.sayHello();
}

void loop() {
  updateSensors();
  sample_light();
  updateImu();

  Button::Event press = button.update(false);
  if (greetingDone && press == Button::LONG_PRESS) {
    showLayers = !showLayers;
    matrixDark = false;
    layers.start();
    Serial.println(showLayers ? "Display: on" : "Display: off");
  }
  if (greetingDone && press == Button::SHORT_PRESS) {
    paused = !paused;
    Serial.println(paused ? "Paused" : "Carrying on");
    if (paused) {
      face.tuneIn(Face::NEUTRAL);
    } else {
      layers.start();
    }
  }

  if (!greetingDone) {
    face.update();
    if (!face.isTalking()) {
      greetingDone = true;
      layers.start();
    }
    leftWheel.drive(0);
    rightWheel.drive(0);
  } else if (paused) {
    face.update();
    matrixDark = false;
    leftWheel.drive(0);
    rightWheel.drive(0);
  } else {
    int before = inControl;
    arbitrate();
    if (inControl != before) {
      Serial.printf("Control: %s\n", behaviourName(HIERARCHY[inControl]));
    }
    leftWheel.drive(wheelLeft);
    rightWheel.drive(wheelRight);
    if (showLayers) {
      drawLayers();
    } else if (!matrixDark) {
      FastLED.clear(true);             // display off: dark, and nothing more to draw
      matrixDark = true;
    }
  }

  keyA.showColour(&Palette::RED);      // a bumper pushes away: red, like the setup screens
  keyC.showColour(&Palette::RED);
  printStatus();
  leftWheel.update();
  rightWheel.update();
}
