doubleonick/behavior_based_bots/firmware/shared/Spikes.h

/*
  Spikes - what the wiring is doing, shown on the 5x5 matrix while Val drives.

  Each sensor is a "lane": its dot sits on the top row (in the same spot as on the
  setup screens), and it sends spikes down its own column, faster the more it feels.
  Green spikes are + wires, red spikes are - wires.
  The bottom row is the wheel. It fires its own white spikes, spreading out from the
  middle, at the speed the wheel is actually being driven.
  With two wheels (setWheels), the bottom row is split: the two LEDs on the left are
  the left wheel, the two on the right the right wheel, each firing at its own speed.
  White = forwards, amber = backwards (amber is the wheels' colour on the setup screens).

  Like a real nerve, a lane never goes quite silent: even with nothing to feel it
  sends a slow spike now and then.

  Usage:
    CRGB leds[25];
    Spikes spikes(leds);
    spikes.start();                         // clear, when switching to spikes
    spikes.setLanes(2);                     // how many sensors are wired
    spikes.setLane(0, 0.7f, +1);            // lane 0 feels 0.7, + wire
    spikes.setLane(1, 0.2f, -1);            // lane 1 feels 0.2, - wire
    spikes.setWheel(0.5f);                  // wheel driven at half speed
    spikes.setWheels(0.3f, -0.6f);          // or two wheels: left forwards, right backwards
    void loop() { spikes.update(); }        // call as often as possible; redraws ~25x/second

  LED layout expected: index = row * 5 + col, row 0 at the top (same as Face).
  update() calls FastLED.show() itself whenever it draws a new frame.
*/
#pragma once
#include <Arduino.h>
#include <FastLED.h>
#include "Canvas.h"

class Spikes {
public:
  static const int MAX_LANES = 3;

  explicit Spikes(CRGB* leds);

  void start();                                  // forget old spikes and start drawing afresh
  void setLanes(int count);                      // 0..3 sensors
  void setLane(int lane, float level, float weight);   // level 0..1, weight +1 or -1
  void setWheel(float speed);                    // one wheel: 0..1 (the size of its speed)
  void setWheels(float left, float right);       // two wheels: -1..1 each (negative = backwards)

  bool update();                                 // returns true when a new frame was drawn

private:
  static const int MAX_AGES = 4;                 // spikes in flight per lane

  struct Lane {
    float level = 0;
    float weight = 1;
    float phase = 0;                             // counts up; a spike leaves at each whole number
    int   ages[MAX_AGES];                        // frames since each spike left (-1 = none)
  };

  struct Wheel {
    float speed = 0;                             // -1..1
    float phase = 0;
    int   ages[MAX_AGES];
  };

  CRGB*    _leds;
  Lane     _lane[MAX_LANES];
  int      _count = 0;
  bool     _twoWheels = false;
  Wheel    _wheel[2];                            // one wheel uses _wheel[0]
  FrameTimer _timer;
  Canvas   _canvas;

  void clearAges(int* ages);
  void addAge(int* ages);
  void ageAll(int* ages, int maxAge);
  void fireWheel(Wheel& wheel);
  void drawWheel(const Wheel& wheel, int fromCol, int toCol, int startCol);
};
