doubleonick/behavior_based_bots/firmware/Val_Field/FieldSetup.h

/*
  FieldSetup - the one-button setup screens for the potential-field robot.

    0. Half a second of white static (see Static.h).
    1. Wheels. S1 is the LEFT wheel, S2 the RIGHT wheel.
         S1 turns slowly "forward" (amber dot bottom-left).
           Wrong way? Short press flips it. Long press confirms.
         Then the same for S2 (amber dot bottom-right).
    2. For each sensor that is plugged in:
         policy: + (green) pull / attract,  - (red) push / repel,  x (grey) off.
                 Short press changes, long press confirms.
         angle:  an arrow shows which way the sensor points on the robot.
                 Short press turns it 45 degrees anticlockwise, long press confirms.
         low:    no stimulus, long press.    light: moon (cover it)   distance: small square (far)
         high:   full stimulus, long press.  light: sun (light it)    distance: big square (near)
         (angle, low and high are skipped when the policy is "off"; reflective IR uses
          the distance squares; a key skips low and high: it is only pressed or not)
       The top row has one dot per sensor; confirmed sensors show their colour.
    3. A check mark, then setup ends (the sketch then tunes the face back in).

  When only a newly plugged sensor needs setting up, the wheel steps are skipped.
  While setup is running it owns the LEDs and both servos.
*/
#pragma once
#include <Arduino.h>
#include <FastLED.h>
#include "Canvas.h"
#include "Button.h"
#include "MotionServo.h"
#include "PotentialField.h"

class FieldSetup {
public:
  FieldSetup(CRGB* leds, MotionServo& leftWheel, MotionServo& rightWheel);

  // sources = the field sources to set up (up to 3).
  // withWheels = true for a full setup; false when only new sensors need setting up.
  void start(PotentialField::Source** sources, int count, bool withWheels);
  void handle(Button::Event e);
  void update();                       // call every loop while active()

  bool active() const { return _phase != OFF; }
  bool takeFinished();                 // true once, right after setup ends

  // Angle steps: 0..7, each 45 degrees anticlockwise from forward
  static float angleFromStep(int step);
  static int   stepFromAngle(float angle);

private:
  enum Phase : uint8_t { OFF, ENTER, WHEEL_LEFT, WHEEL_RIGHT, POLICY, ANGLE, LOW_POINT, HIGH_POINT, DONE };

  CRGB*        _leds;
  MotionServo& _left;
  MotionServo& _right;
  Phase        _phase = OFF;
  uint32_t     _phaseMs = 0;
  FrameTimer   _timer;
  PotentialField::Source* _sources[3];
  int          _count = 0;
  int          _current = 0;
  bool         _finished = false;
  bool         _withWheels = true;
  Canvas       _canvas;

  void goTo(Phase p);
  void nextSource();
  void flip(MotionServo& servo);

  void drawDots(float t);
  void drawMeter(float level);
  void drawArrow(int step, const Canvas::Color& rgb, float intensity);
  void draw();
};
