doubleonick/behavior_based_bots/firmware/Unit_Tester/Unit_Tester.ino

/*
  Unit_Tester - see what the Grove ports' pins are doing, on the matrix and on Serial.

  For trying units that can't say what they are (Reflective IR, Key, ...) before any
  of Val's sketches rely on them. It knows nothing about the units: it reads the six
  port pins, and for each pin tests whether anything is driving it.

  Hardware: M5 Atom Matrix (on the Atom Motion base, for Ports B and C)
              Port A: G26, G32   both can read analog
              Port B: G23, G33   only G33 can read analog
              Port C: G19, G22   neither can read analog

  The matrix shows one port at a time:
    middle column: which port (top dot = A, middle = B, bottom = C)
    left two columns:  the port's first pin  (A: G26, B: G23, C: G19)
    right two columns: the port's second pin (A: G32, B: G33, C: G22)
    Each pin is a bar from the bottom: how high its reading is (0..4095; an on/off
    pin is empty or full). Its colour says what is holding the pin:
      grey  = floating: nothing drives it (an empty pin, or an input such as an LED's
              data line, or a button that isn't pressed and has no pull resistor)
      green = held HIGH by something
      red   = held LOW by something
    (an analog voltage in between shows green or red, and its bar shows the level)

  Button (press the matrix):
    short press: show the next port
    long press:  arm the KEY LED TEST on the port shown. Then press the Key: the pin
                 whose state CHANGES (either way) is the button, and the other pin is
                 driven as an SK6812 LED. (Only after the press, so a pin is never
                 driven by accident.) Long press again to stop.
    During the key LED test, a short press sends the LED the next colour instead:
                 red, green, blue, white, off, ... (full brightness; Serial says which).
                 If the LED changes every time, it works; if it is stuck on its first
                 colour, it only took the first update.

  "What is holding the pin?": the pin is read once with the ESP32's weak pull-up and
  once with its weak pull-down. Floating = it follows them (HIGH, then LOW). Held HIGH
  = HIGH both times. Held LOW = LOW both times.

  Serial (115200 baud), twice a second: every pin's reading and what is holding it.

  Library needed: FastLED.
*/

#include <FastLED.h>

// ---------- Settings ----------
const uint8_t LED_BRIGHTNESS = 20;    // the matrix, out of 255: keep low, it is very bright and gets warm
const int MATRIX_PIN = 27;
const int BUTTON_PIN = 39;            // the matrix is the button (LOW when pressed)

// ---------- The six port pins ----------
struct PortPin {
  const char* port;
  int pin;
  bool hasAdc;                        // can it read a voltage (analog)?
};

const int PIN_COUNT = 6;
const PortPin PINS[PIN_COUNT] = {
  {"A", 26, true}, {"A", 32, true},
  {"B", 23, false}, {"B", 33, true},
  {"C", 19, false}, {"C", 22, false}
};
const char* const PORT_NAMES[3] = {"A", "B", "C"};

// What is holding a pin, found by reading it with the weak pull-up and pull-down
enum Hold : uint8_t { FLOATING, HELD_HIGH, HELD_LOW, ODD };   // ODD: LOW with pull-up, HIGH with pull-down

// What we know about each pin
struct PinState {
  int value = 0;                      // 0..4095 (an on/off pin reads 0 or 4095)
  Hold hold = FLOATING;
};
PinState state[PIN_COUNT];

// The key LED test
struct KeyTest {
  bool armed = false;                 // waiting for the key to be pressed
  int port = -1;                      // which port it was armed on
  Hold before[2] = {FLOATING, FLOATING};   // the port's two pins when it was armed
  int buttonPin = -1;                 // index into PINS, once found
  int ledPin = -1;
  bool ledAdded = false;
  int colourStep = 0;                 // which test colour the LED is showing
};

// The colours the key LED test steps through, sent at full brightness
const int TEST_COLOURS = 5;
const char* const TEST_COLOUR_NAMES[TEST_COLOURS] = {"red", "green", "blue", "white", "off"};
const uint8_t TEST_COLOUR_RGB[TEST_COLOURS][3] = {{255, 0, 0}, {0, 255, 0}, {0, 0, 255}, {255, 255, 255}, {0, 0, 0}};
KeyTest keyTest;

CRGB leds[25];
CRGB keyLed[1];
int shownPort = 0;
unsigned long lastTestMs = 0;
unsigned long lastReadMs = 0;
unsigned long lastPrintMs = 0;
unsigned long lastDrawMs = 0;
bool buttonDown = false;
unsigned long buttonDownMs = 0;

// =====================================================================
//  Reading the pins
// =====================================================================
// Is the pin a key LED we are driving? Then leave it alone.
bool isDrivenByUs(int k) {
  return keyTest.ledAdded && k == keyTest.ledPin;
}

// Read with the weak pull-up, then with the weak pull-down. An empty pin follows them.
void testHold(int k) {
  int pin = PINS[k].pin;
  pinMode(pin, INPUT_PULLUP);
  delayMicroseconds(200);
  int withPullUp = digitalRead(pin);
  pinMode(pin, INPUT_PULLDOWN);
  delayMicroseconds(200);
  int withPullDown = digitalRead(pin);
  if (withPullUp == HIGH && withPullDown == LOW) {
    state[k].hold = FLOATING;
  } else if (withPullUp == HIGH && withPullDown == HIGH) {
    state[k].hold = HELD_HIGH;
  } else if (withPullUp == LOW && withPullDown == LOW) {
    state[k].hold = HELD_LOW;
  } else {
    state[k].hold = ODD;
  }
}

const char* holdName(Hold h) {
  switch (h) {
    case FLOATING:  return "floating ";
    case HELD_HIGH: return "held HIGH";
    case HELD_LOW:  return "held LOW ";
    case ODD:       return "odd      ";
  }
  return "?";
}

// Leave the pin ready for reading: analog pins with no pull; on/off pins with the
// pull-down, so a floating line reads LOW (empty) rather than HIGH
void prepareForReading(int k) {
  if (PINS[k].hasAdc) {
    pinMode(PINS[k].pin, INPUT);
  } else {
    pinMode(PINS[k].pin, INPUT_PULLDOWN);
  }
}

void readPin(int k) {
  if (PINS[k].hasAdc) {
    state[k].value = analogRead(PINS[k].pin);
  } else {
    state[k].value = (digitalRead(PINS[k].pin) == HIGH) ? 4095 : 0;
  }
}

void updatePins() {
  unsigned long now = millis();
  // While the key test waits for a press, look often, so a quick press isn't missed
  unsigned long testEvery = (keyTest.armed && keyTest.buttonPin < 0) ? 20 : 250;
  if (now - lastTestMs >= testEvery) {
    lastTestMs = now;
    for (int k = 0; k < PIN_COUNT; k++) {
      if (isDrivenByUs(k)) {
        continue;
      }
      testHold(k);
      prepareForReading(k);
    }
  }
  if (now - lastReadMs >= 20) {
    lastReadMs = now;
    for (int k = 0; k < PIN_COUNT; k++) {
      if (isDrivenByUs(k)) {
        continue;
      }
      readPin(k);
    }
  }
}

// =====================================================================
//  The key LED test
// =====================================================================
// FastLED needs the pin when it is compiled, so there is one line per possible pin
void addKeyLed(int pin) {
  if (pin == 26) {
    FastLED.addLeds<SK6812, 26, GRB>(keyLed, 1);
  } else if (pin == 32) {
    FastLED.addLeds<SK6812, 32, GRB>(keyLed, 1);
  } else if (pin == 23) {
    FastLED.addLeds<SK6812, 23, GRB>(keyLed, 1);
  } else if (pin == 33) {
    FastLED.addLeds<SK6812, 33, GRB>(keyLed, 1);
  } else if (pin == 19) {
    FastLED.addLeds<SK6812, 19, GRB>(keyLed, 1);
  } else if (pin == 22) {
    FastLED.addLeds<SK6812, 22, GRB>(keyLed, 1);
  }
}

// Set the key LED's test colour (shown with the next frame). FastLED runs at full
// brightness in this sketch, and only the matrix's own pixels are dimmed (in draw()),
// so the key LED gets the colour at full brightness.
void sendTestColour() {
  const uint8_t* rgb = TEST_COLOUR_RGB[keyTest.colourStep];
  keyLed[0] = CRGB(rgb[0], rgb[1], rgb[2]);
  Serial.printf("Key LED: sent %s (%d, %d, %d)\n", TEST_COLOUR_NAMES[keyTest.colourStep],
                rgb[0], rgb[1], rgb[2]);
}

void nextTestColour() {
  keyTest.colourStep = (keyTest.colourStep + 1) % TEST_COLOURS;
  sendTestColour();
}

void updateKeyTest() {
  if (!keyTest.armed || keyTest.buttonPin >= 0) {
    return;
  }
  // Waiting for the press: whichever of the port's pins changes state, either way
  for (int j = 0; j < 2; j++) {
    int k = keyTest.port * 2 + j;
    int other = keyTest.port * 2 + (1 - j);
    if (state[k].hold != keyTest.before[j]) {
      keyTest.buttonPin = k;
      keyTest.ledPin = other;
      Serial.printf("Key test: button on G%d (%s -> %s), LED on G%d. Short press: next LED colour.\n",
                    PINS[k].pin, holdName(keyTest.before[j]), holdName(state[k].hold), PINS[other].pin);
      addKeyLed(PINS[other].pin);
      keyTest.ledAdded = true;
      keyTest.colourStep = 0;
      sendTestColour();
      return;
    }
  }
}

void armOrStopKeyTest() {
  if (keyTest.armed) {
    if (keyTest.ledAdded) {
      keyLed[0] = CRGB::Black;
      FastLED.show();
      Serial.println("Key test stopped (the LED pin stays an LED until you restart)");
    } else {
      Serial.println("Key test stopped");
    }
    keyTest.armed = false;
    return;
  }
  keyTest = KeyTest();
  keyTest.armed = true;
  keyTest.port = shownPort;
  keyTest.before[0] = state[shownPort * 2].hold;
  keyTest.before[1] = state[shownPort * 2 + 1].hold;
  Serial.printf("Key test armed on Port %s: press the key\n", PORT_NAMES[shownPort]);
}

// =====================================================================
//  The matrix
// =====================================================================
void putLed(int row, int col, const CRGB& c) {
  leds[row * 5 + col] = c;
}

// One pin as a bar in two columns, filling from the bottom
void drawPin(int k, int col) {
  CRGB colour;
  if (isDrivenByUs(k)) {
    colour = keyLed[0];               // the key LED: show what it is showing
  } else if (state[k].hold == HELD_HIGH) {
    colour = CRGB(0, 255, 60);        // green: held HIGH
  } else if (state[k].hold == HELD_LOW) {
    colour = CRGB(255, 0, 0);         // red: held LOW
  } else if (state[k].hold == ODD) {
    colour = CRGB(255, 110, 0);       // amber: odd (shouldn't happen)
  } else {
    colour = CRGB(50, 50, 60);        // grey: floating, nothing drives it
  }
  float level = isDrivenByUs(k) ? 5 : state[k].value / 4095.0f * 5;
  for (int row = 0; row < 5; row++) {
    int fromBottom = 4 - row;
    float fill = constrain(level - fromBottom, 0.0f, 1.0f);
    CRGB c = colour;
    c.nscale8_video((uint8_t)(40 + 215 * fill));
    if (fill <= 0) {
      c = CRGB(colour).nscale8_video(18);   // a dim outline, so an empty bar still shows
    }
    putLed(row, col, c);
    putLed(row, col + 1, c);
  }
}

void draw() {
  unsigned long now = millis();
  if (now - lastDrawMs < 40) {
    return;
  }
  lastDrawMs = now;
  for (int n = 0; n < 25; n++) {
    leds[n] = CRGB::Black;
  }
  drawPin(shownPort * 2, 0);
  drawPin(shownPort * 2 + 1, 3);
  // which port: a dot in the middle column, top = A, middle = B, bottom = C
  CRGB marker = keyTest.armed ? CRGB(255, 110, 0) : CRGB(180, 180, 200);   // amber while the key test is armed
  putLed(shownPort * 2, 2, marker);
  // Dim only the matrix (the key LED stays at full brightness)
  for (int n = 0; n < 25; n++) {
    leds[n].nscale8_video(LED_BRIGHTNESS);
  }
  FastLED.show();
}

// =====================================================================
//  Serial
// =====================================================================
void printPins() {
  unsigned long now = millis();
  if (now - lastPrintMs < 500) {
    return;
  }
  lastPrintMs = now;
  for (int k = 0; k < PIN_COUNT; k++) {
    if (isDrivenByUs(k)) {
      Serial.printf("%s G%d  key LED   ", PINS[k].port, PINS[k].pin);
    } else {
      Serial.printf("%s G%d %4d %s  ", PINS[k].port, PINS[k].pin, state[k].value,
                    holdName(state[k].hold));
    }
    if (k % 2 == 1) {
      Serial.printf("| ");
    }
  }
  Serial.printf("\n");
}

// =====================================================================
//  The button
// =====================================================================
void updateButton() {
  bool down = digitalRead(BUTTON_PIN) == LOW;
  unsigned long now = millis();
  if (down && !buttonDown) {
    buttonDown = true;
    buttonDownMs = now;
  } else if (!down && buttonDown) {
    buttonDown = false;
    if (now - buttonDownMs < 30) {
      return;                         // a bounce
    }
    if (now - buttonDownMs < 700) {
      if (keyTest.armed && keyTest.ledAdded) {
        nextTestColour();               // during the key LED test: the next colour
      } else {
        shownPort = (shownPort + 1) % 3;
        Serial.printf("Showing Port %s\n", PORT_NAMES[shownPort]);
      }
    } else {
      armOrStopKeyTest();
    }
  }
}

// =====================================================================
//  Setup / loop
// =====================================================================
void setup() {
  Serial.begin(115200);
  delay(200);
  pinMode(BUTTON_PIN, INPUT);
  FastLED.addLeds<WS2812, MATRIX_PIN, GRB>(leds, 25);
  FastLED.setBrightness(255);         // full: draw() dims the matrix itself, so the key LED can be bright
  FastLED.clear(true);
  for (int k = 0; k < PIN_COUNT; k++) {
    prepareForReading(k);
  }
  Serial.println("Unit tester: short press = next port, long press = key LED test on this port");
  Serial.println("Each pin: reading (0..4095) and what holds it: floating / held HIGH / held LOW");
}

void loop() {
  updateButton();
  updatePins();
  updateKeyTest();
  draw();
  printPins();
}
