doubleonick/behavior_based_bots/tests/host/vehicle_neuron_favourite/main.cpp

// Host test for Vehicle 4a: a neuron AGAINST the wire (a favourite level), graded
// (gain 1), on Val_Vehicle's Light Unit.
// Story: Light Unit in Port A, + wire, threshold 0.5, the neuron holds back twice
// what it fires. Setup as in vehicle_light. From 14 s the light climbs in steps:
// 0.10, 0.30, 0.50 (the favourite: fastest, half speed), 0.70 (slower again: 0.30),
// 0.90 (nearly still: 0.10). Three seconds each.
#define PORT_A_UNIT LIGHT_UNIT
#define PORT_A_NEURON Connection::AGAINST_THE_WIRE
#define PORT_A_THRESHOLD 0.5f
#include <Arduino.h>
#include <Wire.h>
#include <FastLED.h>
uint32_t fakeMillis=1; bool fakeButtonDown=false; int servoAngle=-1;
// Nothing answers on I2C in any port.
FakeSensor fakeSensors[3] = {{-9,-9,false,'C',0},{-9,-9,false,'C',0},{-9,-9,false,'D',0}};
FakeSerial Serial; TwoWire Wire, Wire1; FakeFastLED FastLED;
TwoWire& TwoWire::wireMain(){ return Wire; }
#include "Val_Vehicle.ino"
struct Press { float at, len; };
int main(){
  Press presses[] = {
    {6.0,1.0},{7.5,1.0},{9.0,1.0},{10.5,1.0} };          // mount, Light +, low (dark), high (lit)
  setup(); bool lastSetup=false;
  for(fakeMillis=5; fakeMillis<29000; fakeMillis+=5){
    float t=fakeMillis/1000.0f; fakeButtonDown=false;
    for(auto&p:presses){ if(t>=p.at && t<p.at+p.len) fakeButtonDown=true; }
    // the level on G32: dark for "low" (200), lit for "high" (3800), then the story
    if(t>8.5 && t<10.1){ fakeAnalog[32]=200; } else if(t>10.1 && t<11.6){ fakeAnalog[32]=3800; }
    else if(t<14){ fakeAnalog[32]=200; }
    else if(t<17){ fakeAnalog[32]=560; } else if(t<20){ fakeAnalog[32]=1280; }
    else if(t<23){ fakeAnalog[32]=2000; } else if(t<26){ fakeAnalog[32]=2720; }
    else { fakeAnalog[32]=3440; }
    loop();
    if(setupMode.active()!=lastSetup){ lastSetup=setupMode.active(); ::printf("   >> t=%.2fs setup %s\n", t, lastSetup?"STARTS":"ends"); }
  }
}
