doubleonick/behavior_based_bots/(commit log)

2026-10-19 First commit: Val firmware, host tests and project docs
    Val is an educational robot with a face: an M5Stack Atom Matrix on an
    Atom Motion base, with plug-in Grove sensors.
    - firmware/Val_Vehicle: Braitenberg vehicle (sensors wired +/-/off to one servo)
    - firmware/Val_Field: potential field (sensors push/pull; two wheels)
    - firmware/shared: the classes both sketches use, kept in step by
    firmware/sync_shared.py
    - tests/host: runs both sketches against fake hardware and compares output
    - CLAUDE.md, docs/hardware.md, FUTURE_WORK.md: working rules, hardware
    notes, and the plan for a web guide with a story for kids and notes for
    parents (web/)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
2026-10-19 Web guide: draft chapter outline and decisions so far
    Outline in web/OUTLINE.md (V1, V2a/b, V3a/b, field, subsumption; options for
    state machines and ANNs; portable progress). FUTURE_WORK.md records the frame,
    the instructions-only decision, and that per-browser progress alone was rejected.
    Claude-Session: https://claude.ai/code/session_0177ombTgtJfgtCS8kZVYuUW
2026-10-20 Record Val's character design decisions so far
    Pixel art rendered from the chassis STLs, part colours, how two modules join,
    the face chosen on the robot with a signal display on the other module, and
    the web guide asking which module has the face.
    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
2026-10-20 Val_Vehicle: show spikes while driving, a face when the run is over
    New shared class Spikes draws the wiring's activity on the matrix: one lane
    per sensor (green + / red -, faster the more it feels) and the wheel firing
    along the bottom row at its real speed. The face stays for interactions
    (hello, setup, surprise at a new sensor). After the wheel has been still for
    1.5 s a face tunes back in: Love if only - wires stopped it, else Neutral.
    The vehicle host test now makes C and later A into - wires so both resting
    faces appear; expected output updated. Setup starts one loop (5 ms) later
    because the face now updates after the greeting check.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
2026-10-22 Val_Field: find a PaHub and use sensors on its channels
    A port answering at 0x70 is treated as a PaHub; its six channels become
    places to look for sensors ("Hub 0" to "Hub 5"), so two distance sensors
    or two light sensors can share one port. Port gains a channel, and
    I2CBus::use() switches the hub to a sensor's channel before every read.
    Still at most 3 sensors (the setup screens' limit).
    New host test field_hub: two distance sensors on a hub push the robot away
    from an obstacle, then two light sensors on the same channels pull it
    toward a light. Existing test output is unchanged.
    Claude-Session: https://claude.ai/code/session_0177omb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
2026-10-22 Val_Field: show spikes while driving
    Spikes gains a two-wheel mode: the bottom row is split into the left wheel
    (two LEDs on the left) and the right wheel, each firing at its own speed,
    white forwards and amber backwards. Val_Field shows it while the wheels
    turn, with one lane per sensor (green pull, red push) ordered left to right
    by where each sensor points, and prints that order on Serial. When both
    wheels have been still for 1.5 s the Neutral face tunes back in.
    The PaHub test now matches the real wiring (right sensor on channel 0, left
    on channel 1). Field tests' setup starts 5 ms later, as in Val_Vehicle.
    Claude-Session: https:/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
2026-10-22 Record that mid-chassis wheels fixed Val_Field's arc
    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
2026-10-22 Val_Vehicle: show each vehicle's emotion from how the run goes
    Two new faces in Face: Scared (tall trembling eyes, wobbly zigzag mouth) and
    Curious (eyes glance up and off to one side, smiling).
    A module can't tell crossed from straight wires, so it reads the run:
    + wires feeling a lot at full speed for 1 s (charging) -> Angry for 3 s;
    - wires whose feeling fades from a peak while the wheel speeds up (moving
    on) -> Curious for 3 s; then back to spikes. When the wheel stops: + wires
    -> Scared, - wires -> Love, mixed -> Neutral.
    New host test vehicle_emotions plays all four. Existing outputs unchanged.
    Claude-Session: https://claude.ai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
2026-10-23 Add Val_Brooks: a subsumption test bench
    Behaviours in a fixed hierarchy: each asks every loop whether it wants the
    wheels, and the highest one that does drives them. Pick one of seven test
    hierarchies by uncommenting a TEST_ line: escape left / right collision,
    avoid / approach object, avoid / approach light (each over wander), or
    escape front collision -> avoid object -> approach light -> wander.
    Detection: is_button_collision, is_inertial_collision (BMI270, compiled in
    with INERTIAL_COLLISION 1), is_left/right/front_collision choosing between
    them by that flag, is_distance_threshold, is_light_gradient_threshold.
    Primitives: straight_forward/backward, arc_forward/backward_left/right;
    wand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
2026-10-23 Val_Brooks: long press switches the behaviour display off and on
    With it off the matrix is dark and gives nothing away, for an ethology
    exercise: work out the hierarchy from behaviour alone. SHOW_LAYERS_AT_START
    sets how it begins. The brooks host test toggles it; control is unchanged.
    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
2026-10-23 Add a firmware code survey and tidy-up plan
    docs/code-survey.md: how the ~4,800 lines split between the matrix,
    hardware and control, what the sketches duplicate, proposed shared classes
    (Canvas, Palette, Icons, SetupScreens, SensorRack, Settings, Mood,
    SpikeTrain), a folder layout, and a safe order to do it in. Nothing in the
    code has changed.
    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
2026-10-24 Shared Canvas, Palette and Icons for everything drawn on the matrix
    Step 1 of docs/code-survey.md. Face, Spikes, Layers and both setup-screen
    classes had their own 25-pixel frame, "brightest wins" put, 40 ms timer,
    squared-brightness push and colour tables. Now they all draw on Canvas
    (with FrameTimer), take colours from Palette and pictures from Icons.
    Static's colour moved to Palette::STATIC.
    Every LED frame of every host story is identical before and after
    (compared frame by frame, ~5,900 frames). To keep later steps honest, each
    test's fake FastLED now checksums every frame and prints it at the end;
    the only change to expected.txt is that new line.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
2026-10-25 Fix Val_Vehicle for the Arduino IDE: declare Wiring above every function
    The Arduino IDE writes a declaration for every function in a .ino above the
    first function, so wiringKind()'s declaration came before enum Wiring and
    the sketch did not compile on the robot (it did with g++ in the host tests).
    Moved the enum up with the other declarations.
    tests/host/run.py now fails a test whose .ino declares a type, used in a
    function's return type or parameters, below the first function. Checked
    that it catches the old Val_Vehicle.
    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
2026-10-25 Support the M5 Reflective IR (Port B) and Key (Port C) units
    New shared Sensor children: ReflectiveIRSensor reads G33 as analog and is
    calibrated like the others; KeySensor is pressed or not (setup skips its
    calibration), learns which pin is the button on the first press, and lights
    its LED in the wire's / policy's colour, brighter while pressed.
    They can't identify themselves, so each sketch assumes them when no I2C
    sensor answers in Port B / C (ASSUME_IR_ON_PORT_B / ASSUME_KEY_ON_PORT_C);
    setup lets the child switch one off, and an I2C sensor plugged in later
    takes over. In Val_Field real I2C sensors (ports and PaHub) get the setup
    screens' three slots first. In Val_Brooks a single Key is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
2026-10-25 Add Unit_Tester: port pins on the matrix, for trying new units
    A standalone sketch (FastLED only, no shared files) for checking units that
    can't identify themselves before the Val sketches rely on them. For each of
    the six port pins it shows the reading (0..4095; on/off pins 0 or 4095) as
    a bar, and whether anything drives the pin (read with the weak pull-up and
    then the weak pull-down: an empty pin follows them). Short press: next port.
    Long press arms a key LED test on the port shown: when a pin goes LOW (the
    key), the other pin is driven as an SK6812 LED cycling colours. Serial
    prints every pin twice a second.
    New host test unit_tester with fake pins that float or are driven.
    Co-Authore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
2026-10-25 Record the Reflective IR measurements from Unit_Tester
    Analog IR works on Port A (G32); the unit's digital output is on each port's
    first pin and its analog output on the second. On Port B the analog pin
    (G33) only reads low or high, probably because of pull-ups on that port.
    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
2026-10-25 Unit_Tester: name each pin's state, find a key's button either way
    From the first Key test on the robot: the button's pin sits floating when not
    pressed and jumps to HIGH when pressed, so the old "pin goes LOW" test never
    fired. The tester now reports each pin as floating / held HIGH / held LOW
    (grey / green / red on the matrix), reads on/off pins with the pull-down so a
    floating line reads empty, and takes as the key's button whichever pin
    changes state after the test is armed.
    Recorded the Key finding in docs/hardware.md; KeySensor still assumes the
    opposite and needs changing before the Val sketches can use a key.
    Claude-Session: h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
2026-10-25 Unit_Tester: step the key LED through fixed colours at full brightness
    On the robot the key LED lit green once and never cycled. To find out why,
    the LED test now sends one fixed colour per short press (red, green, blue,
    white, off) and Serial says which, at full brightness: FastLED runs at 255
    and only the matrix's own pixels are dimmed. While armed, the port's pins
    are checked every 20 ms so a quick press isn't missed.
    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
2026-10-25 Record how the Motion's battery charges, and the battery vs USB difference
    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
2026-10-26 Key Unit works on all three ports; Port B's wires are the other way round
    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
2026-10-26 Add IR_Test: the Reflective IR Unit alone, on Port A or B
    Also record that the Key works on battery on all three ports, but on USB
    the LED does not turn red when pressed.
    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
2026-10-26 Note the PbHub as a way to read analog and Key units over I2C
    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
2026-10-26 Val_Vehicle: Key, ToF and Reflective IR vehicles, chosen by #define
    - ReflectiveIRSensor reads the unit's on/off output on G33 (Port B is wired the
    other way round, so its analog output lands on G23, which has no ADC). Raw
    4095 = sees something, 0 = not; no calibration.
    - The Key is a bumper: + wire drives forwards until pressed, then backwards;
    - wire the opposite. The wheel may reverse while a key is wired.
    - ASSUME_IR_ON_PORT_B / ASSUME_KEY_ON_PORT_C now default to 0 in Val_Vehicle:
    switch one on and reflash. The ToF is found by itself.
    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
2026-10-27 Val_Vehicle: the reflective IR cruises at 1/4 speed; seeing adds or takes 1/2
    + wire: 0.25 -> 0.75 forwards when it sees something. - wire: 0.25 forwards
    -> 0.25 backwards. IR_CRUISE and IR_CHANGE set the numbers. New host test
    vehicle_ir runs the IR vehicle alone, with - and then + wiring.
    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
2026-10-27 Val_Vehicle, Val_Field: IR or Light Unit in Port A as a level (PORT_A_UNIT)
    - ReflectiveIRSensor reads its level on G32 in Port A (calibrated), and still
    on/off on G33 in Port B (for Val_Brooks).
    - New shared LightUnitSensor: the Light Unit's level on G32, Port A only.
    - Val_Vehicle and Val_Field: PORT_A_UNIT = NO_UNIT / IR_UNIT / LIGHT_UNIT
    replaces ASSUME_IR_ON_PORT_B. Both are plain wires (like the ToF); the IR
    vehicle's cruise wiring is dropped (recorded in FUTURE_WORK.md).
    - Val_Field: the Key is off by default.
    - Host tests: vehicle_units now has the IR in Port A; vehicle_ir becomes
    vehicle_light (the Light Unit alone).
    C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
2026-10-27 Add firmware/examples: six standalone beginner sketches, one device each
    Servo, ToF, Reflective IR, Light Unit, Key and Color Unit (R, G, B, clear),
    each drawing what it reads on the matrix, with hook-up notes saying which
    port gives a level, on/off, or works at all. README with the port table.
    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
2026-10-28 Add cad/mg996_brick_mount.scad: brick-compatible frame and horn adapter for an MG996
    A frame the servo drops through and screws to by its ears, with Technic pin
    holes on the 8 mm grid through its sides and ends, and a horn adapter with a
    cross-axle hole and four pin holes. Extrapolated from M5Stack's LEGO-compatible
    servo kits using Technic dimensions; MG996 sizes are from listings and need
    measuring. Preview images rendered with OpenSCAD.
    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
2026-10-28 cad: MG996 clamp that pins the servo's broad side to a Technic beam
    Replaces the frame as the main part, as M5's kits do it: a cradle covering one
    broad face, with two Technic pin holes HOLE_GAP_PEGS apart (6 = 48 mm for a
    standard servo, 3 on M5's micro servo), end blocks the ears screw onto, and a
    cable slot at each end. The frame stays as an alternative part.
    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
2026-11-03 cad: add the current robot chassis (vechicles_v2.scad, foundational_modules.scad)
    The owner's latest CAD for the physical robots used for Vehicle, Field and
    Brooks (a mirrored pair). vechicles_v2.scad includes foundational_modules.scad,
    so the two stay side by side. Added as provided.
    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
2026-11-04 cad: servo_wheel.scad, the vechicles_v2 wheel and tire as a one-piece servo horn
    A copy of the wheel sketched in vechicles_v2.scad (same rim, tire bulge and
    four Technic peg holes), with WIDTH as a setting and a servo hub:
    HUB = "m5" (a Technic cross-axle hole, for M5's LEGO-compatible servos) or
    "horn" (a pocket for an SG90-style horn plus its centre screw). Prints as one
    part, or split into a TPU tire and a rigid core. Horn sizes are guesses to
    measure; the stock SG90 horn needs a wheel about 34 mm or larger.
    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
2026-11-05 cad/render: Val's V1 avatar as pixel art, rendered from the chassis CAD
    val_v1_render.py exports the chassis from vechicles_v2.scad (through
    val_v1_chassis.scad), adds the Motion base, battery, Atom Matrix and face, wheel,
    servo, counterweight nut and the front sensor between two 2x4 L beams (placed
    from photos of the built robot), and draws three views with pix.py.
    val_v1_above_rear.png is the chosen avatar. Record the art direction in
    FUTURE_WORK.md.
    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
2026-11-09 Vehicle 1 lesson mock-up, Val's V1 clips, and the video tools
    - web/mockups/v1-lesson/: the design canvas source (the working lesson, the
    same-rule-same-trail board, the notebook style, the filming setup, the Val
    renders), with a README.
    - web/media/v1/: the + and - clips (converted from HDR, trimmed, no sound).
    - tools/video/: convert_clip.sh (HDR to web MP4, trim, quarter turn) and
    track_clip.py (Val's path by its blue battery, and the pool of light). Both
    reproduce the clips and paths used in the lesson.
    - FUTURE_WORK.md: the lesson's decisions and what was dropped.
    Claude-Session: https://claude.ai/code/session_0177ombTgtJf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
2026-11-09 Expedition map and Handbook mock-ups; the guide's tone is settled
    - web/mockups/v1-lesson/Expedition.dc.html: an Indiana Jones style map with a
    red route, the prologue and a short story scene per stop (placeholders),
    Val's position, and the expedition journal (the notebook entries).
    - web/mockups/v1-lesson/Handbook.dc.html: the appendix for helpers and advanced
    explorers; Stop 1 drafted from the lesson's notes, the rest placeholders.
    - web/OUTLINE.md and FUTURE_WORK.md: tone is the expedition; everything is
    written to the child, adult material moves to the Handbook.
    Claude-Session: https://claude.ai/code/session_0177ombTgtJfgtC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
2026-11-10 Expedition map: the travelled route is dotted all the way, as the key says
    The leg into Val's current stop was drawn as a solid line so it could draw
    itself in. It is now dotted, revealed along the route by a mask instead.
    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
2026-11-12 Vehicle 4: curved wires in Val_Vehicle (test bench)
    A wire can be STRAIGHT (as before, the default), HUMP (4a: a favourite
    level) or STEP (4b: a threshold, with a small gap so it doesn't chatter).
    Set per port in the sketch for now, not in setup on the robot.
    Host tests vehicle_step and vehicle_hump added. Not yet run on the robot.
    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
2026-11-12 Vehicle 4 rebuilt around one neuron; a start on Vehicle 5's memory
    The formula curves are replaced by a Neuron part: it adds its inputs, is
    silent below a threshold, fires harder above it, and follows its input
    over a short time. Gain sets graded or all-or-none. A neuron that listens
    to itself stays on. In Val_Vehicle a wire can have one neuron in it (4b)
    or against it (4a). Settings in the sketch; no neuron = no change.
    Host tests replaced and one added. Not yet run on the robot.
    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
2026-11-14 Save the setup mock-ups and record the neuron setup design
    Three click-through mock-ups of the 5x5 matrix go into web/mockups/setup/.
    FUTURE_WORK records the agreed (not built) setup for a wire's nerve cell:
    place, threshold, strength, self; and the first run of 4a, 4b and memory
    on the robot.
    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
2026-11-14 IMU_Test: explore the Matrix's motion sensor as a safety reflex
    A standalone sketch: a bubble level on the matrix; tilt, total g and jolts
    on Serial; the button sets level; an optional trial that stops the wheel
    while Val is not level. Reads the BMI270 (v1.1) or the MPU6886 (v1.0,
    from the data sheet, untried). Not yet run on the robot.
    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
